RobotGrrl/EJA_v2/base_stage/base_stage.png

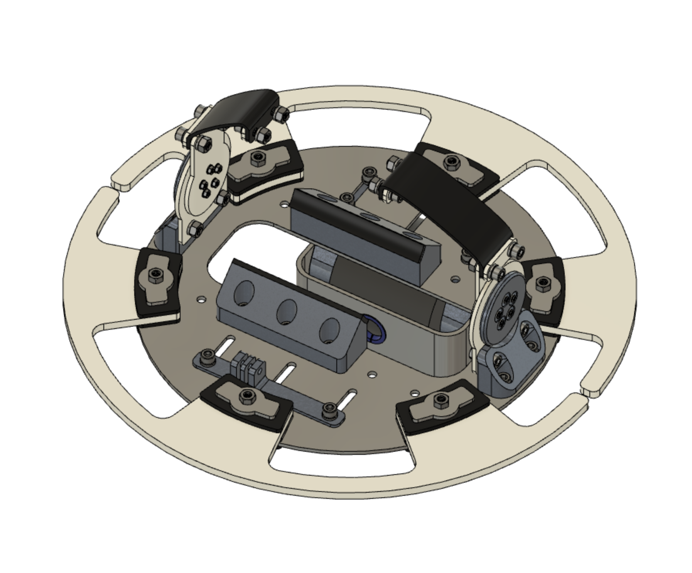
base_stage/base_stage.png
