RobotGrrl/EJA_v2/deck_stage/deck_stage.png

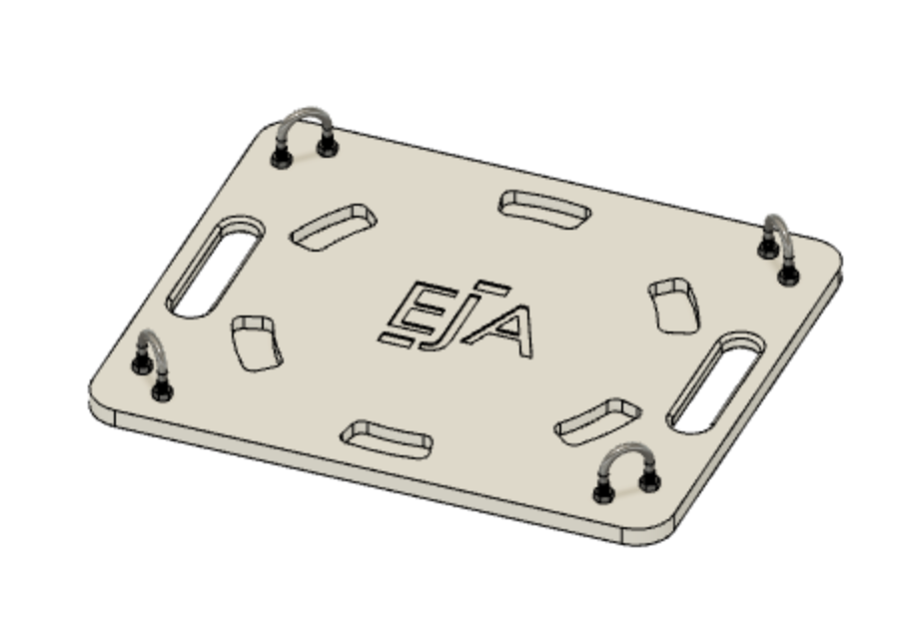
deck_stage/deck_stage.png
