RobotGrrl/EJA_v2/internal_buoy/O-ring 1:8 Internal - Milled Screenshot.png

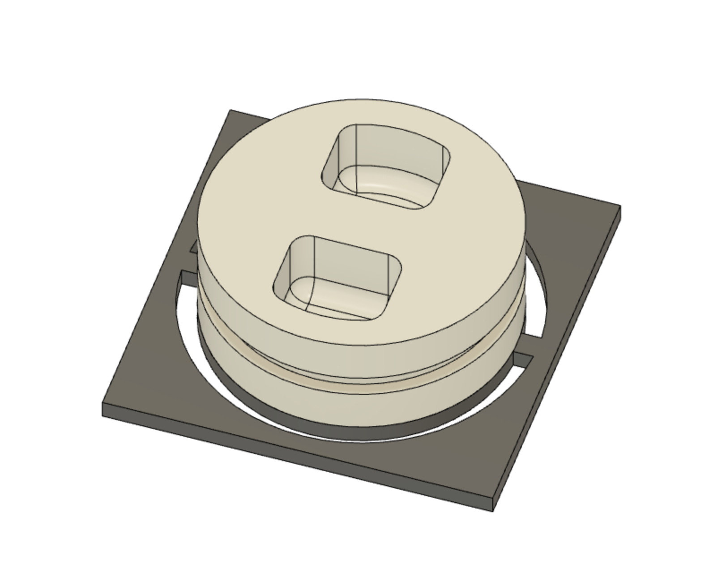
internal_buoy/O-ring 1:8 Internal - Milled Screenshot.png
