RobotGrrl/EJA_v2/lower_stage/lower_stage.png

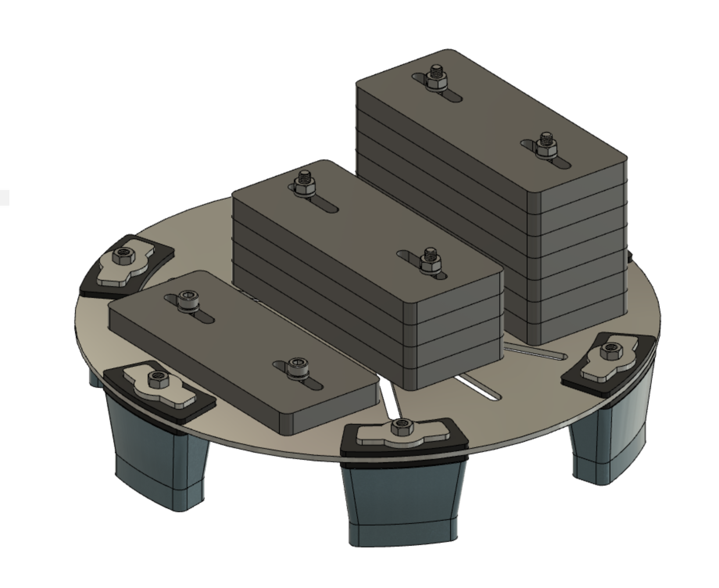
lower_stage/lower_stage.png
