RobotGrrl/EJA_v2/sim/sim.png

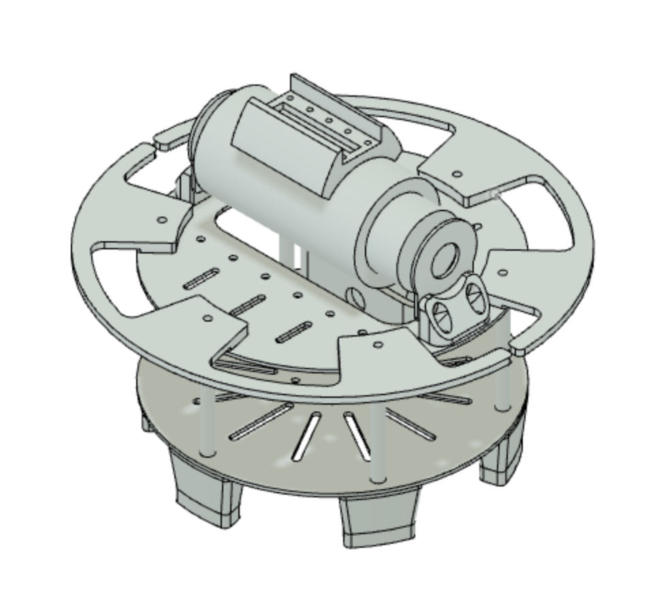
sim/sim.png
