RobotGrrl/EJA_v2/EJA v2 BOM [FINAL] - OTHER BOM.pdf

Item | Qty | Price | Cost
Paracord $14.80 (https://www.amazon.ca/WEREWOLVES-650lb-Paracord-Parachute-Cord/dp/B0922HQ9KZ?s=sports) | 1 | 14.8 | 14.8
Bungee cord $10.99 (https://www.amazon.ca/Paracord-Planet-Elastic-Crafting-Stretch/dp/B06X3RJ4P2) | 1 | 10.99 | 10.99
Carabiners 2x | 2 | 3 | 6
Nalgene 1L wide-mouth | 1 | 12 | 12

Magnets
Dimensions: 3/4" x 1/4" x 1/4" thick | 10 | 1.67 | 16.70 | https://www.kjmagnetics.com/proddetail.asp?prod=BC44 wiper
Dimensions: 3/16" dia. x 1/4" thick | 20 | 0.47 | 9.40 | https://www.kjmagnetics.com/proddetail.asp?prod=D34-N52 servo module (default A)
TOTAL | 69.89

Scratchpad of magnets tested

description | price | num buoys | qty | cost | link | note
Dimensions: 1/4" dia. x 1/4" thick | 0.72 | 1 | 25 | 18.00 https://www.kjmagnetics.com/proddetail.asp?prod=D44-N52 wiper
Dimensions: 1/2" x 1/4" x 1/4" thick | 1.17 | 1 | 15 | 17.55 https://www.kjmagnetics.com/proddetail.asp?prod=B844 wiper
Dimensions: 3/4" x 1/4" x 1/4" thick | 1.67 | 1 | 10 | 16.70 https://www.kjmagnetics.com/proddetail.asp?prod=BC44 wiper
Dimensions: 3/16" dia. x 1/4" thick | 0.47 | 4 | 20 | 9.40 https://www.kjmagnetics.com/proddetail.asp?prod=D34-N52 servo module (default A)
Dimensions: 3/16" dia. x 1/8" thick | 0.29 | 4 | 20 | 5.80 https://www.kjmagnetics.com/proddetail.asp?prod=D32-N52 servo module (B)
total | 67.45
