RobotGrrl/EJA_v2/EJA v2 BOM [FINAL].xlsx

Sheet: COMPLETE FASTENER BOM
 | EJA v2 Bill of Materials Please read through and observe the notes. There might be some differences in the pricing! Last updated: Nov. 4, 2021
 | Useful Links: hackaday.io project page Design Github repository Electronics Github repository
Component | Location | Qty | Part Number | Part Qty | Pack Cost | Pack Qty | TOTAL Cost | Notes | Pack / Qty Needed | # of Packs Needed for 4 Complete Assemblies | Pack / Qty Needed | TOTAL Cost
M6 Hex nut | Lower stage | 24
M6 Hex nut | Base stage | 8
M6 Hex nut | External buoy | 2
TOTAL M6 Hex nut |  | 34 | 90591A151 (https://www.mcmaster.com/90591A151) | 1 | 2.99 | 100 | 2.99 |  | 2.941176471 | 2 | 5.882352941 | 5.98
M6 Washer | Base stage | 20
M6 Washer | Lower stage | 16
M6 Washer | External buoy | 4
TOTAL M6 Washer |  | 40 | 98688A116 (https://www.mcmaster.com/98688A116) | 2 | 4.29 | 100 | 8.58 | It seemed like we needed more than 100, go with 200 | 2.5 | 2 | 5 | 8.58
M6 x 16 mm | Base stage | 20 | 90128A263 (https://www.mcmaster.com/90128A263) | 1 | 10.36 | 100 | 10.36 |  | 5 | 1 | 5 | 10.36
M6 x 20 mm | Base stage | 8 | 90128A264 (https://www.mcmaster.com/90128A264) | 1 | 11.97 | 100 | 11.97 |  | 12.5 | 1 | 12.5 | 11.97
M6 x 25 mm | Lower stage | 2 | 90128A265 (https://www.mcmaster.com/90128A265) | 1 | 13.22 | 100 | 13.22 |  | 50 | 1 | 50 | 13.22
M6 x 35 mm | External buoy | 2 | 90128A267 (https://www.mcmaster.com/90128A267) | 1 | 8.59 | 50 | 8.59 |  | 25 | 1 | 25 | 8.59
M6 x 40 mm | Lower stage | 2
M6 x 50 mm | Lower stage | 2
M6 x 60 mm | Lower stage | 2 | 90128A271 (https://www.mcmaster.com/90128A271/) | 1 | 6.43 | 25 | 6.43
M6 Wing Nut | Lower stage | 8 | 94300A330 (https://www.mcmaster.com/94300A330) | 1 | 6.09 | 25 | 6.09 |  | 3.125 | 2 | 6.25 | 12.18
M3 Washers | Base stage | 20
M3 Washers | External wiper | 10
M3 Washer | Internal buoy | 46
TOTAL M3 Washers |  | 76 | 93475A210 (https://www.mcmaster.com/93475A210) | 2 | 1.62 | 100 | 3.24 | It seemed like we needed more than 100, go with 200 | 1.315789474 | 4 | 5.263157895 | 6.48
M3 Hex Nut | Base stage | 10
M3 Hex Nut | Internal buoy | 20
TOTAL M3 Hex nut |  | 30 | 90591A250 (https://www.mcmaster.com/90591A250) | 1 | 2.67 | 100 | 2.67 |  | 3.333333333 | 2 | 6.666666667 | 5.34
M3 Heatset | External wiper | 10
M3 Heatset | Internal buoy | 8
TOTAL M3 Heatset |  | 18 | 94180A331 (https://www.mcmaster.com/94180A331) | 1 | 14.71 | 100 | 14.71 |  | 5.555555556 | 1 | 5.555555556 | 14.71
M3 x 8 mm Thin | Internal buoy | 4 | 90666A104 (https://www.mcmaster.com/90666A104) | 1 | 8.4 | 100 | 8.4 |  | 25 | 1 | 25 | 8.4
M3 x 8 mm | Internal buoy | 22 | 91290A113 (https://www.mcmaster.com/91290A113) | 0 | 8.12 | 100 | 0 |  | 4.545454545 | 1 | 4.545454545 | 8.12
M3 x 8 mm | Internal buoy | 22 | 95263A122 (https://www.mcmaster.com/95263A122/) | 1 | 8.12 | 100 | 8.12
M3 x 10 mm | Internal buoy | 4 | 95263A134 (https://www.mcmaster.com/95263A134) | 1 | 8.14 | 50 | 8.14 |  | 12.5 | 1 | 12.5 | 8.14
M3 x 14 mm | Base stage | 10 | 91502A106 (https://www.mcmaster.com/91502A106) | 1 | 11.95 | 100 | 11.95 |  | 10 | 1 | 10 | 11.95
M3 x 16 mm | External wiper | 10 | 91290A120 (https://www.mcmaster.com/91290A120) | 1 | 10.11 | 100 | 10.11 |  | 10 | 1 | 10 | 10.11
M3 Hex Nut Thin | Internal buoy | 4 | 90695A033 (https://www.mcmaster.com/90695A033) | 1 | 4.03 | 100 | 4.03 |  | 25 | 1 | 25 | 4.03
M3 Nylon Washer | Internal buoy | 12 | 95610A130 (https://www.mcmaster.com/95610A130) | 1 | 3.81 | 100 | 3.81 | These 4 and the next 4 had supplychain issues - so it's a mixture of both | 8.333333333 | 1 | 8.333333333 | 3.81
M3 Nylon Hex Nut | Internal buoy | 4 | 93800A116 (https://www.mcmaster.com/mv1630010695/itmLookup/itmLookup.aspx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) | 0 | 14.64 | 100 | 0 | These 4 and the next 4 had supplychain issues - so it's a mixture of both | 25 | 1 | 25 | 14.64
M3 x 10 mm Nylon | Internal buoy | 2 | 92492A718 (https://www.mcmaster.com/92492A718-94879A120/) | 0 | 10.04 | 100 | 0 | These 4 and the next 4 had supplychain issues - so it's a mixture of both | 50 | 1 | 50 | 10.04
M3 x 16 mm Nylon | Internal buoy | 2 | 94879A126 (https://www.mcmaster.com/mv1630010695/itmLookup/itmLookup.aspx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) | 0 | 10.2 | 100 | 0 | These 4 and the next 4 had supplychain issues - so it's a mixture of both | 50 | 1 | 50 | 10.2
4-40 Nylon Washer | Internal buoy | 12 | 90295A345 (https://www.mcmaster.com/90295A345-90295A045/) | 0 | 3.81 | 100 | 0 | These 4 and the next 4 had supplychain issues - so it's a mixture of both | 8.333333333 | 1 | 8.333333333 | 3.81
4-40 Nylon Hex Nut | Internal buoy | 4 | 94812A200 (https://www.mcmaster.com/94812A200-94812A112/) | 1 | 14.64 | 100 | 14.64 | These 4 and the next 4 had supplychain issues - so it's a mixture of both | 25 | 1 | 25 | 14.64
4-40 x 7/16" (10 mm) Nylon | Internal buoy | 2 | 95868A259 (https://www.mcmaster.com/95868A259-95868A109/) | 1 | 10.04 | 100 | 10.04 | These 4 and the next 4 had supplychain issues - so it's a mixture of both | 50 | 1 | 50 | 10.04
4-40 x 11/16" (16 mm) Nylon | Internal buoy | 2 | 95868A270 (https://www.mcmaster.com/95868A270-95868A120/) | 1 | 10.2 | 100 | 10.2 | These 4 and the next 4 had supplychain issues - so it's a mixture of both | 50 | 1 | 50 | 10.2
M2 Heatset | Internal buoy | 8 | 94180A312 (https://www.mcmaster.com/94180A312) | 1 | 15.04 | 100 | 15.04 |  | 12.5 | 1 | 12.5 | 15.04
M2 Washer | Internal buoy | 8 | 93475A195 (https://www.mcmaster.com/93475A195) | 1 | 1.36 | 100 | 1.36 |  | 12.5 | 1 | 12.5 | 1.36
M2 x 6 mm | Internal buoy | 4 | 91292A831 (https://www.mcmaster.com/91292A831) | 1 | 6 | 100 | 6 |  | 25 | 1 | 25 | 6
M2 x 10 mm | Internal buoy | 4 | 90128A181 (https://www.mcmaster.com/90128A181) | 1 | 12.88 | 100 | 12.88 |  | 25 | 1 | 25 | 12.88
M6 x 80 mm Threaded rod | Lower stage (Ballast) | 2
M6 x 115 mm Threaded rod | Lower stage (Ballast) | 2
M6 x 160 mm Threaded Rod | Base stage (Spool) | 1
M6 x 170 mm Threaded Rod | Assembly | 6
M6 Threaded Rods |  | 9 | 98863A542 (https://www.mcmaster.com/98863A542) | 1 | 3.31 | 1 | 3.31 |  | 0.1111111111 | 36 | 4 | 119.16
1/4" dia x 1/4" len Magnet | External wiper | 5 | 5862K116 (https://www.mcmaster.com/5862K116) | 0 | 0.97 | 0 | 0 | Magnets purchased from K&J magnetics | 0 | 25 | 0 | 24.25
1/4" dia x 1/4" len Magnet | Internal buoy | 7 | 5862K116 (https://www.mcmaster.com/5862K116) | 0 | 0.97 | 0 | 0 | Magnets purchased from K&J magnetics | 0 | 35 | 0 | 33.95
3/16" dia x 1/4" len Magnet | Internal buoy | 4 | 5862K115 (https://www.mcmaster.com/5862K115) | 0 | 0.88 | 1 | 0 | Magnets purchased from K&J magnetics | 0.25 | 16 | 4 | 14.08
O-ring | Internal buoy | 1 | 9452K62 (https://www.mcmaster.com/9452K62) | 1 | 15.07 | 100 | 15.07 |  | 100 | 1 | 100 | 15.07
Foam | External buoy and Base stage | 0.25 | 7503N61 (https://www.mcmaster.com/7503N61) | 1 | 14.87 | 1 | 14.87 |  | 4 | 1 | 4 | 14.87
U-Bolt | Deck stage | 4 | 3043T614 (https://www.mcmaster.com/3043T614) | 1 | 3.74 | 5 | 3.74 |  | 1.25 | 4 | 5 | 14.96
1/4"-20 Hex Nut | Deck stage | 16 | 95462A029 (https://www.mcmaster.com/95462A029) | 1 | 5.56 | 100 | 5.56 |  | 6.25 | 1 | 6.25 | 5.56
 |  |  |  |  | FASTENERS TOTAL |  | 256.12 |  |  |  | GRAND TOTAL | 502.72
 |  |  |  |  | OTHER TOTAL |  | 69.89
 |  |  |  |  | GRAND TOTAL |  | 326.01

Sheet: OTHER BOM
Item | Qty | Price | Cost
Paracord $14.80 (https://www.amazon.ca/WEREWOLVES-650lb-Paracord-Parachute-Cord/dp/B0922HQ9KZ?s=sports) | 1 | 14.8 | 14.8
Bungee cord $10.99 (https://www.amazon.ca/Paracord-Planet-Elastic-Crafting-Stretch/dp/B06X3RJ4P2) | 1 | 10.99 | 10.99
Carabiners 2x | 2 | 3 | 6
Nalgene 1L wide-mouth | 1 | 12 | 12
Magnets
Dimensions: 3/4" x 1/4" x 1/4" thick | 10 | 1.67 | 16.70 |  | https://www.kjmagnetics.com/proddetail.asp?prod=BC44 | wiper
Dimensions: 3/16" dia. x 1/4" thick | 20 | 0.47 | 9.40 |  | https://www.kjmagnetics.com/proddetail.asp?prod=D34-N52 | servo module (default A)
 |  | TOTAL | 69.89
Scratchpad of magnets tested
description | price | num buoys | qty | cost | link | note
Dimensions: 1/4" dia. x 1/4" thick | 0.72 | 1 | 25 | 18.00 | https://www.kjmagnetics.com/proddetail.asp?prod=D44-N52 | wiper
Dimensions: 1/2" x 1/4" x 1/4" thick | 1.17 | 1 | 15 | 17.55 | https://www.kjmagnetics.com/proddetail.asp?prod=B844 | wiper
Dimensions: 3/4" x 1/4" x 1/4" thick | 1.67 | 1 | 10 | 16.70 | https://www.kjmagnetics.com/proddetail.asp?prod=BC44 | wiper
Dimensions: 3/16" dia. x 1/4" thick | 0.47 | 4 | 20 | 9.40 | https://www.kjmagnetics.com/proddetail.asp?prod=D34-N52 | servo module (default A)
Dimensions: 3/16" dia. x 1/8" thick | 0.29 | 4 | 20 | 5.80 | https://www.kjmagnetics.com/proddetail.asp?prod=D32-N52 | servo module (B)
 |  |  | total | 67.45

Sheet: Threaded Rod Calculator
M6 x 80 mm Threaded rod | Lower stage (Ballast) | 2 | 200 mm
M6 x 115 mm Threaded rod | Lower stage (Ballast) | 2 | Len 1 | Len 2 | Remainder
M6 x 160 mm Threaded Rod | Base stage (Spool) | 1 | 80 | 115 | 5
M6 x 170 mm Threaded Rod | Assembly | 6 | 80 | 115 | 5
 |  |  | 170 |  | 30
 |  |  | 170 |  | 30
 |  |  | 170 |  | 30
 |  |  | 170 |  | 30
 |  |  | 170 |  | 30
 |  |  | 170 |  | 30
 |  |  | 160 |  | 40
 |  |  | 200 mm x 9 | 29.79 | WINNER

Sheet: Lower Stage
Component | Location | Quantity | Part Number (Benchtop) | Part Cost (Benchtop) | Part Number (Deployed) | Part Cost (Deployed) | Notes | M6 Hex Nut | M6 Washer | M6 Hex Nut | M6 Washer
M6 Hex nut | Bumper-washer top | 6 | 90591A151 |  |  |  |  | 1 |  | 6 | 0
M6 Hex nut | Stands | 6 | 90591A151 |  |  |  |  | 1 |  | 6 | 0
M6 Hex nut | Ballast bay 3 | 2 | 90591A151 |  |  |  |  | 1 |  | 2 | 0
M6 Washer | Ballast bay 3 | 4 | 98688A116 |  |  |  |  |  | 1 | 0 | 4
M6 x 25 mm | Ballast bay 3 | 2 | 90128A265 |  |  |  |  |  |  | 0 | 0
M6 Hex nut | Ballast bay 2 | 4 | 90591A151 |  |  |  |  | 1 |  | 4 | 0
M6 Washer | Ballast bay 2 | 4 | 98688A116 |  |  |  |  |  | 1 | 0 | 4
M6 x 80 mm Threaded rod | Ballast bay 2 | 2 | TODO |  | 98863A542 |  | Cut to 80 mm Stack of 4 x 1/2" ballasts |  |  | 0 | 0
M6 Hex nut | Ballast bay 1 | 4 | 90591A151 |  |  |  |  | 1 |  | 4 | 0
M6 Washer | Ballast bay 1 | 4 | 98688A116 |  |  |  |  |  | 1 | 0 | 4
M6 x 115 mm Threaded rod | Ballast bay 1 | 2 | TODO |  | 98863A542 |  | Cut to 115 mm Stack of 7 x 1/2" ballasts |  |  | 0 | 0
M6 Hex nut | Ballast bay (optional) | 2 | 90591A151 |  |  |  |  | 1 |  | 2 | 0
M6 Washer | Ballast bay (optional) | 4 | 98688A116 |  |  |  |  |  | 1 | 0 | 4
M6 x 40 mm | Ballast bay (optional) | 2 | TODO |  |  |  | Stack of 2 x 1/2" ballasts |  |  | 0 | 0
M6 x 50 mm | Ballast bay (optional) | 2 | TODO |  |  |  | Stack of 3 x 1/2" ballasts |  |  | 0 | 0
M6 x 70 mm | Ballast bay (optional) | 2 | TODO |  |  |  | Stack of 4 x 1/2" ballasts |  |  | 0 | 0
 |  |  |  |  |  |  |  |  |  | 24 | 16
TOTAL BOM
M6 Hex nut | 24
M6 Washer | 16
M6 x 25 mm | 2
M6 x 80 mm Threaded rod | 2
M6 x 115 mm Threaded rod | 2
M6 x 40 mm | 2
M6 x 50 mm | 2
M6 x 70 mm | 2

Sheet: Base Stage
Component | Location | Quantity | Part Number (Benchtop) | Part Cost (Benchtop) | Part Number (Deployed) | Part Cost (Deployed) | Notes | M6 Washer | M6 Hex Nut | M6 x 16 mm | M6 x 20 mm | M3 Washers | M3 Hex Nut | M3 x 14 mm | M6 Washer | M6 Hex Nut | M6 x 16 mm | M6 x 20 mm | M3 Washers | M3 Hex Nut | M3 x 14 mm
M6 Hex nut | Fasteners - Rod (mirror) lower surface | 6 |  |  |  |  |  |  | 1 |  |  |  |  |  | 0 | 6 | 0 | 0 | 0 | 0 | 0
M6 Hex nut | Fasteners - Rod top surface | 6 |  |  |  |  |  |  | 1 |  |  |  |  |  | 0 | 6 | 0 | 0 | 0 | 0 | 0
Nylon grommet | Spool | 1 |  |  |  |  |  |  |  |  |  |  |  |  | 0 | 0 | 0 | 0 | 0 | 0 | 0
M6 Washers | Spool | 8 |  |  |  |  |  | 1 |  |  |  |  |  |  | 8 | 0 | 0 | 0 | 0 | 0 | 0
M6 Hex nut | Spool | 4 |  |  |  |  |  |  | 1 |  |  |  |  |  | 0 | 4 | 0 | 0 | 0 | 0 | 0
M6 x 16 mm | Spool | 4 |  |  |  |  |  |  |  | 1 |  |  |  |  | 0 | 0 | 4 | 0 | 0 | 0 | 0
M6 Washers | Spool | 2 |  |  |  |  |  | 1 |  |  |  |  |  |  | 2 | 0 | 0 | 0 | 0 | 0 | 0
M6 Hex nut | Spool | 2 |  |  |  |  |  |  | 1 |  |  |  |  |  | 0 | 2 | 0 | 0 | 0 | 0 | 0
M6 x 160 mm Threaded Rod | Spool | 1 |  |  |  |  |  |  |  |  |  |  |  |  | 0 | 0 | 0 | 0 | 0 | 0 | 0
M6 Washers | Sleeve-Base | 4 |  |  |  |  |  | 1 |  |  |  |  |  |  | 4 | 0 | 0 | 0 | 0 | 0 | 0
M6 Hex nut | Sleeve-Base | 2 |  |  |  |  |  |  | 1 |  |  |  |  |  | 0 | 2 | 0 | 0 | 0 | 0 | 0
M6 x 16 mm | Sleeve-Base | 2 |  |  |  |  |  |  |  | 1 |  |  |  |  | 0 | 0 | 2 | 0 | 0 | 0 | 0
M6 Washers | Sleeve-Base | 4 |  |  |  |  |  | 1 |  |  |  |  |  |  | 4 | 0 | 0 | 0 | 0 | 0 | 0
M6 Hex nut | Sleeve-Base | 2 |  |  |  |  |  |  | 1 |  |  |  |  |  | 0 | 2 | 0 | 0 | 0 | 0 | 0
M6 x 16 mm | Sleeve-Base | 2 |  |  |  |  |  |  |  | 1 |  |  |  |  | 0 | 0 | 2 | 0 | 0 | 0 | 0
M6 Washers | Sleeve-Base | 4 |  |  |  |  |  | 1 |  |  |  |  |  |  | 4 | 0 | 0 | 0 | 0 | 0 | 0
M6 Hex nut | Sleeve-Base | 2 |  |  |  |  |  |  | 1 |  |  |  |  |  | 0 | 2 | 0 | 0 | 0 | 0 | 0
M6 x 20 mm | Sleeve-Base | 2 |  |  |  |  |  |  |  |  | 1 |  |  |  | 0 | 0 | 0 | 2 | 0 | 0 | 0
M6 Washers | Sleeve-Base | 4 |  |  |  |  |  | 1 |  |  |  |  |  |  | 4 | 0 | 0 | 0 | 0 | 0 | 0
M6 Hex nut | Sleeve-Base | 2 |  |  |  |  |  |  | 1 |  |  |  |  |  | 0 | 2 | 0 | 0 | 0 | 0 | 0
M6 x 20 mm | Sleeve-Base | 2 |  |  |  |  |  |  |  |  | 1 |  |  |  | 0 | 0 | 0 | 2 | 0 | 0 | 0
M3 Washers | Sleeve-Base | 10 |  |  |  |  |  |  |  |  |  | 1 |  |  | 0 | 0 | 0 | 0 | 10 | 0 | 0
M3 Hex nut | Sleeve-Base | 5 |  |  |  |  |  |  |  |  |  |  | 1 |  | 0 | 0 | 0 | 0 | 0 | 5 | 0
M3 x 14 mm | Sleeve-Base | 5 |  |  |  |  |  |  |  |  |  |  |  | 1 | 0 | 0 | 0 | 0 | 0 | 0 | 5
M6 Washers | Sleeve-Base Mirror | 4 |  |  |  |  |  | 1 |  |  |  |  |  |  | 4 | 0 | 0 | 0 | 0 | 0 | 0
M6 Hex nut | Sleeve-Base Mirror | 2 |  |  |  |  |  |  | 1 |  |  |  |  |  | 0 | 2 | 0 | 0 | 0 | 0 | 0
M6 x 16 mm | Sleeve-Base Mirror | 2 |  |  |  |  |  |  |  | 1 |  |  |  |  | 0 | 0 | 2 | 0 | 0 | 0 | 0
M6 Washers | Sleeve-Base Mirror | 4 |  |  |  |  |  | 1 |  |  |  |  |  |  | 4 | 0 | 0 | 0 | 0 | 0 | 0
M6 Hex nut | Sleeve-Base Mirror | 2 |  |  |  |  |  |  | 1 |  |  |  |  |  | 0 | 2 | 0 | 0 | 0 | 0 | 0
M6 x 16 mm | Sleeve-Base Mirror | 2 |  |  |  |  |  |  |  | 1 |  |  |  |  | 0 | 0 | 2 | 0 | 0 | 0 | 0
M6 Washers | Sleeve-Base Mirror | 4 |  |  |  |  |  | 1 |  |  |  |  |  |  | 4 | 0 | 0 | 0 | 0 | 0 | 0
M6 Hex nut | Sleeve-Base Mirror | 2 |  |  |  |  |  |  | 1 |  |  |  |  |  | 0 | 2 | 0 | 0 | 0 | 0 | 0
M6 x 20 mm | Sleeve-Base Mirror | 2 |  |  |  |  |  |  |  |  | 1 |  |  |  | 0 | 0 | 0 | 2 | 0 | 0 | 0
M6 Washers | Sleeve-Base Mirror | 4 |  |  |  |  |  | 1 |  |  |  |  |  |  | 4 | 0 | 0 | 0 | 0 | 0 | 0
M6 Hex nut | Sleeve-Base Mirror | 2 |  |  |  |  |  |  | 1 |  |  |  |  |  | 0 | 2 | 0 | 0 | 0 | 0 | 0
M6 x 20 mm | Sleeve-Base Mirror | 2 |  |  |  |  |  |  |  |  | 1 |  |  |  | 0 | 0 | 0 | 2 | 0 | 0 | 0
M3 Washers | Sleeve-Base Mirror | 10 |  |  |  |  |  |  |  |  |  | 1 |  |  | 0 | 0 | 0 | 0 | 10 | 0 | 0
M3 Hex nut | Sleeve-Base Mirror | 5 |  |  |  |  |  |  |  |  |  |  | 1 |  | 0 | 0 | 0 | 0 | 0 | 5 | 0
M3 x 14 mm | Sleeve-Base Mirror | 5 |  |  |  |  |  |  |  |  |  |  |  | 1 | 0 | 0 | 0 | 0 | 0 | 0 | 5
M6 Washers | Holder | 6 |  |  |  |  |  | 1 |  |  |  |  |  |  | 6 | 0 | 0 | 0 | 0 | 0 | 0
M6 Hex nut | Holder | 3 |  |  |  |  |  |  | 1 |  |  |  |  |  | 0 | 3 | 0 | 0 | 0 | 0 | 0
M6 x 16 mm | Holder | 3 |  |  |  |  |  |  |  | 1 |  |  |  |  | 0 | 0 | 3 | 0 | 0 | 0 | 0
M6 Washers | Holder Mirror | 6 |  |  |  |  |  | 1 |  |  |  |  |  |  | 6 | 0 | 0 | 0 | 0 | 0 | 0
M6 Hex nut | Holder Mirror | 3 |  |  |  |  |  |  | 1 |  |  |  |  |  | 0 | 3 | 0 | 0 | 0 | 0 | 0
M6 x 16 mm | Holder Mirror | 3 |  |  |  |  |  |  |  | 1 |  |  |  |  | 0 | 0 | 3 | 0 | 0 | 0 | 0
M6 Washers | GoPro | 4 |  |  |  |  |  | 1 |  |  |  |  |  |  | 4 | 0 | 0 | 0 | 0 | 0 | 0
M6 Hex nut | GoPro | 2 |  |  |  |  |  |  | 1 |  |  |  |  |  | 0 | 2 | 0 | 0 | 0 | 0 | 0
M6 x 16 mm | GoPro | 2 |  |  |  |  |  |  |  | 1 |  |  |  |  | 0 | 0 | 2 | 0 | 0 | 0 | 0
 |  |  |  |  |  |  |  |  |  |  |  |  |  |  | 58 | 42 | 20 | 8 | 20 | 10 | 10
TOTAL BOM
M6 Washer | 58
M6 Hex Nut | 42
M6 x 16 mm | 20
M6 x 20 mm | 8
M3 Washers | 20
M3 Hex Nut | 10
M3 x 14 mm | 10
Nylon grommet | 1
M6 x 160 mm Threaded Rod | 1

Sheet: External Wiper
Component | Location | Quantity | Part Number (Benchtop) | Part Cost (Benchtop) | Part Number (Deployed) | Part Cost (Deployed) | Notes | M6 Hex Nut | M6 Washer | M6 Hex Nut | M6 Washer
M3 x 16 mm | Cap | 10 | 91290A120 |  |  |  |  | 1 |  | 10 | 0
M3 Washer | Cap | 10 | 93475A210 |  |  |  |  | 1 |  | 10 | 0
M3 Heatset | Seatbelt | 10 | 94180A331 |  | 94180A331 |  |  | 1 |  | 10 | 0
Magnets | Holder | 5 |  |  |  |  |  |  |  | 30 | 0
TOTAL BOM
M3 x 16 mm | 10
M3 Washer | 10
M3 Heatset | 10

Sheet: Internal Buoy
Component | Location | Quantity | Part Number (Benchtop) | Part Cost (Benchtop) | Part Number (Deployed) | Part Cost (Deployed) | Notes | M3 Hex Nut | M3 Washer | M3 x 8 mm | M3 Hex Nut | M3 Washer | M3 x 8 mm
M3 x 8 mm | Internal Wiper - Holder | 16 | 91290A113 |  |  |  |  |  |  | 1 | 0 | 0 | 16
M3 Washer | Internal Wiper - Holder | 32 | 93475A210 |  |  |  |  |  | 1 |  | 0 | 32 | 0
M3 Hex Nut | Internal Wiper - Holder | 16 | 90591A250 |  |  |  |  | 1 |  |  | 16 | 0 | 0
M3 x 8 mm Thin | Internal Wiper - Servo Horn | 4 | 90666A104 |  |  |  |  |  |  |  | 0 | 0 | 0
M3 Hex Nut Thin | Internal Wiper - Servo Horn | 4 | 90695A033 |  |  |  |  |  |  |  | 0 | 0 | 0
Magnets | Internal Wiper - Holder | 7 |  |  |  |  |  |  |  |  | 0 | 0 | 0
 |  |  |  |  |  |  |  |  |  |  | 0 | 0 | 0
M3 Washer | Servo Module - Servo Bracket Front | 8 |  |  |  |  |  |  | 1 |  | 0 | 8 | 0
M3 Heatset | Servo Module - Servo Bracket Back | 4 |  |  |  |  |  |  |  |  | 0 | 0 | 0
M3 x 8 mm | Servo Module - Servo Bracket Front | 4 |  |  |  |  |  |  |  | 1 | 0 | 0 | 4
M3 Washer | Servo Module - Servo Bracket Front | 4 |  |  |  |  |  |  | 1 |  | 0 | 4 | 0
M3 Hex Nut | Servo Module - Servo Bracket Front | 4 |  |  |  |  |  | 1 |  |  | 4 | 0 | 0
M3 x 10 mm | Servo Module - Servo Bracket Front | 4 |  |  |  |  |  |  |  |  | 0 | 0 | 0
M2 Heatset | Servo Module - Servo Bracket Back | 4 |  |  |  |  |  |  |  |  | 0 | 0 | 0
M2 Washer | Servo Module - Servo Bracket Key | 4 |  |  |  |  |  |  |  |  | 0 | 0 | 0
M2 x 10 mm | Servo Module - Servo Bracket Key | 4 |  |  |  |  |  |  |  |  | 0 | 0 | 0
M2 Washer | Servo Module - Servo Bracket Mount | 4 |  |  |  |  |  |  |  |  | 0 | 0 | 0
M2 Heatset | Servo Module - Servo Bracket Mount | 4 |  |  |  |  |  |  |  |  | 0 | 0 | 0
M2 x 6 mm | Servo Module - Servo Bracket Mount | 4 |  |  |  |  |  |  |  |  | 0 | 0 | 0
3/16" dia x 1/4" len Magnet | Servo Module - Servo Bracket Back | 2 | 5862K115 |  |  |  |  |  |  |  | 0 | 0 | 0
3/16" dia x 1/4" len Magnet | Servo Module - Servo Bracket Mate | 2 | 5862K115 |  |  |  |  |  |  |  | 0 | 0 | 0
 |  |  |  |  |  |  |  |  |  |  | 0 | 0 | 0
M3 Nylon Washer | Bracket - Board | 12 | 95610A130 |  | 95610A130 |  |  |  |  |  | 0 | 0 | 0
M3 Nylon Hex Nut | Bracket - Board | 4 | 93800A116 |  | 93800A116 |  |  |  |  |  | 0 | 0 | 0
M3 x 16 mm Nylon | Bracket - Board | 2 | 94879A126 |  | 94879A126 |  |  |  |  |  | 0 | 0 | 0
M3 x 10 mm Nylon | Bracket - Board | 2 | 92492A718 |  | 92492A718 |  |  |  |  |  | 0 | 0 | 0
M3 x 8 mm | Bracket - Board - O-ring | 2 |  |  |  |  |  |  |  | 1 | 0 | 0 | 2
M3 Washer | Bracket - Board - O-ring | 2 |  |  |  |  |  |  | 1 |  | 0 | 2 | 0
 |  |  |  |  |  |  |  |  |  |  | 0 | 0 | 0
M3 Heatset | O-ring 1/8 Internal | 4 |  |  |  |  |  |  |  |  | 0 | 0 | 0
O-ring | O-ring 1/8 Internal | 1 |  |  |  |  |  |  |  |  | 0 | 0 | 0
 |  |  |  |  |  |  |  |  |  |  | 20 | 46 | 22
TOTAL BOM
M3 Hex Nut | 20
M3 Washer | 46
M3 x 8 mm | 22
M3 x 8 mm Thin | 4
M3 Hex Nut Thin | 4
Magnets | 7
M3 Heatset | 8
M3 x 10 mm | 4
M2 Heatset | 8
M2 Washer | 8
M2 x 10 mm | 4
M2 x 6 mm | 4
3/16" dia x 1/4" len Magnet | 4
M3 Nylon Washer | 12
M3 Nylon Hex Nut | 4
M3 x 16 mm Nylon | 2
M3 x 10 mm Nylon | 2
O-ring | 1

Sheet: External Buoy
Component | Location | Quantity | Part Number (Benchtop) | Part Cost (Benchtop) | Part Number (Deployed) | Part Cost (Deployed) | Notes | M6 Hex Nut | M6 Washer | M6 Hex Nut | M6 Washer
M6 Washer | Clamp | 4
M6 Hex Nut | Clamp | 2
M6 x 35 mm | Clamp | 2
Foam | Buoy | 0.25 | 7503N61 |  | 7503N61
TOTAL BOM
M6 Washer | 4
M6 Hex Nut | 2
M6 x 35 mm | 2
Foam | 0.25

Sheet: Deck Stage
Component | Location | Quantity | Part Number (Benchtop) | Part Cost (Benchtop) | Part Number (Deployed) | Part Cost (Deployed) | Notes | M6 Hex Nut | M6 Washer | M6 Hex Nut | M6 Washer
U-Bolt | Deck | 4 | 3043T614 | 3.74
1/4-20 Hex Nut | Deck | 16 | 95462A029 | 5.56
TOTAL BOM
