RobotGrrl/EJA_v2/sim/Eja Assembly CFD (v49) 4 v7.step

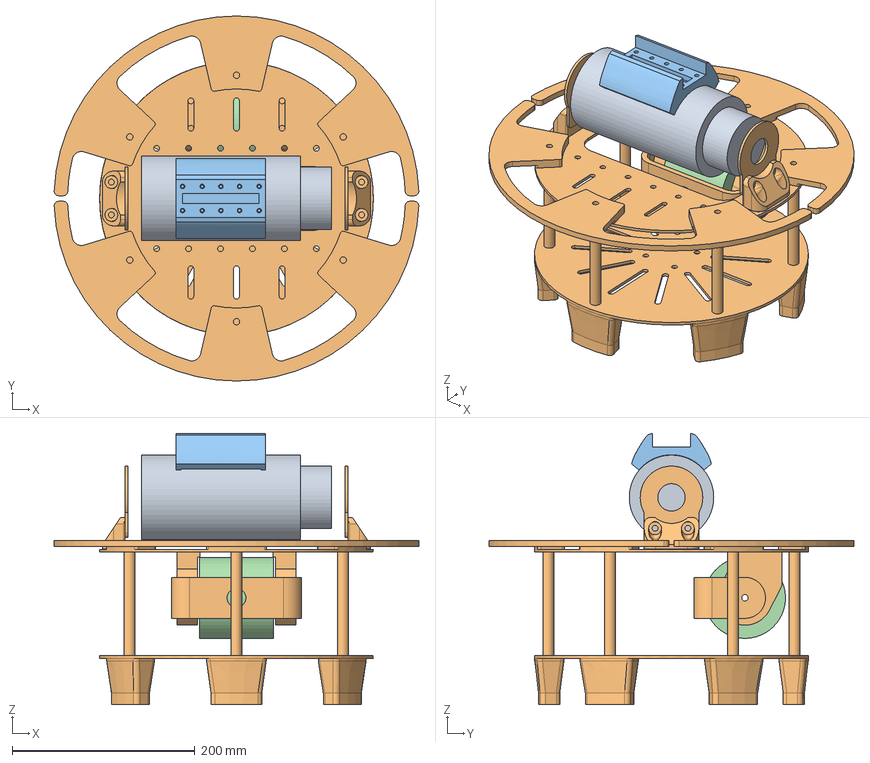
[picture p6: CAD file, 2021-11-04]
sim/Eja Assembly CFD (v49) 4 v7.step
399.7 x 400.0 x 297.5 mm
seatbelt (1)
sleeve (2)
sleeve(Mirror) (2)
sleeve-base bracket (2)
sleeve-base bracket(Mirror) (1)
