RobotGrrl/EJA_v2/assembly/rod_spacer_back.stl

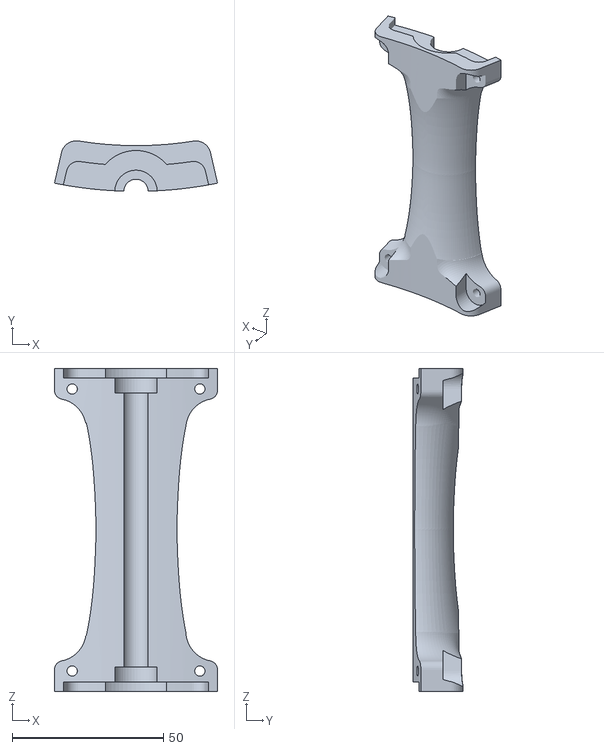
[picture p7: CAD file, 2021-11-04]
assembly/rod_spacer_back.stl
53.9 x 16.6 x 106.7
