RobotGrrl/EJA_v2/base_stage/clasp.dxf

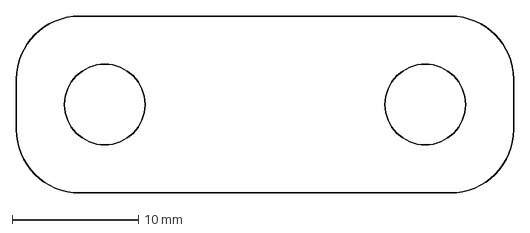
[picture p8: CAD file, 2021-11-04]
base_stage/clasp.dxf
39.4 x 14.0 mm
