RobotGrrl/EJA_v2/deck_stage/bungee_cord.stl

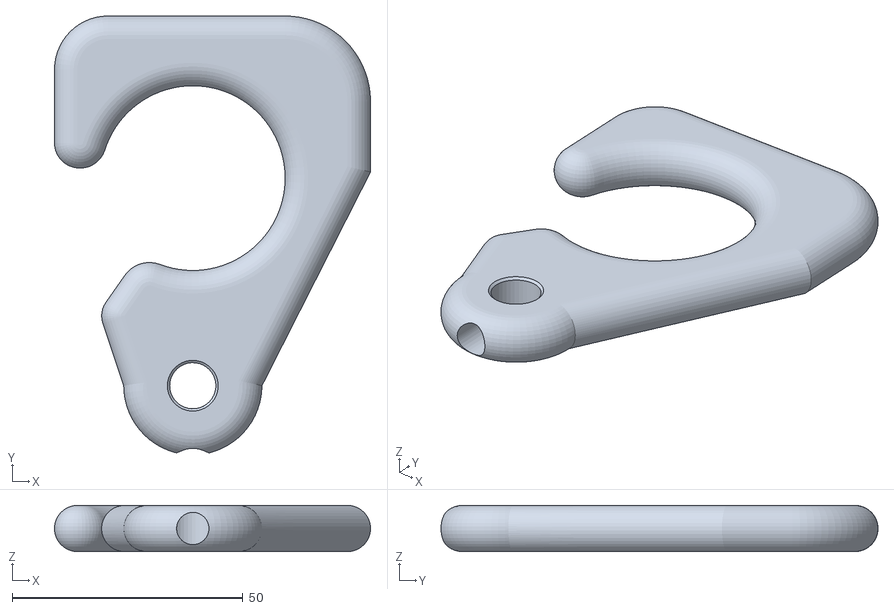
[picture p9: CAD file, 2021-11-04]
deck_stage/bungee_cord.stl
68.5 x 94.7 x 10.0
