RobotGrrl/EJA_v2/external_buoy/handle.dxf

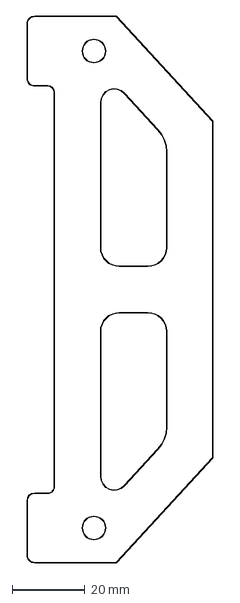
[picture p10: CAD file, 2021-11-04]
external_buoy/handle.dxf
51.0 x 150.0 mm
