RobotGrrl/EJA_v2/external_wiper/magnet_holder_blank.stl

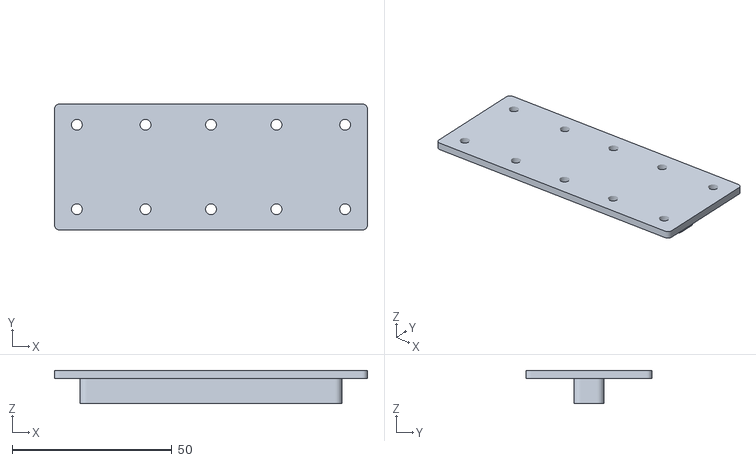
[picture p11: CAD file, 2021-11-04]
external_wiper/magnet_holder_blank.stl
97.9 x 39.4 x 10.4
