RobotGrrl/EJA_v2/internal_buoy/board.stl

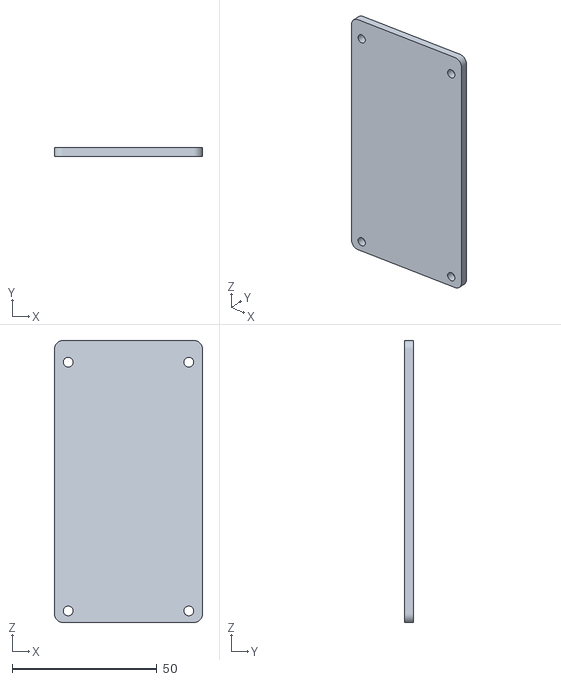
[picture p12: CAD file, 2021-11-04]
internal_buoy/board.stl
51.2 x 3.00 x 97.5
