RobotGrrl/EJA_v2/internal_wiper/metal_wiper_e.dxf

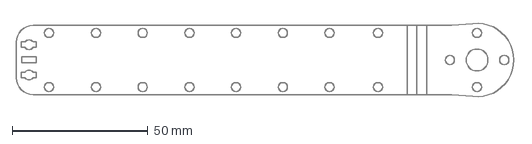
[picture p13: CAD file, 2021-11-04]
internal_wiper/metal_wiper_e.dxf
183.6 x 28.0 mm
