RobotGrrl/EJA_v2/lower_stage/Lower stage v71.step

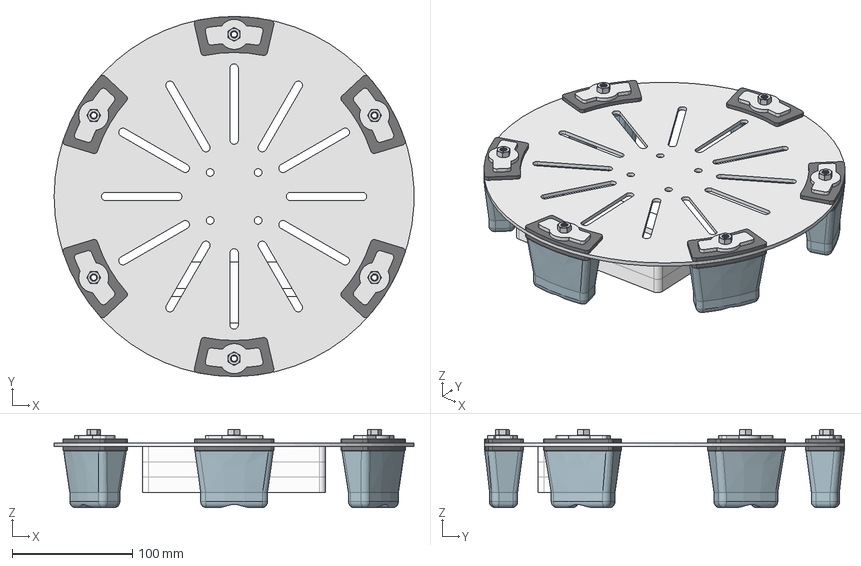
[picture p14: CAD file, 2021-11-04]
lower_stage/Lower stage v71.step
299.8 x 300.0 x 65.4 mm
base
bumper x 6
bumper(Mirror) x 6
washer x 6
M6 90591A151_ZINC-PLATED STEEL HEX NUT x 6
M6 98688A116_ METRIC GENERAL PURPOSE WASHERS x 6
M6 90591A151_ZINC-PLATED STEEL HEX NUT_1 x 6
leg (1) x 6
ballast lower bay 1
