RobotGrrl/EJA_v2/magnet_holders/internal_magnet_holder.stl

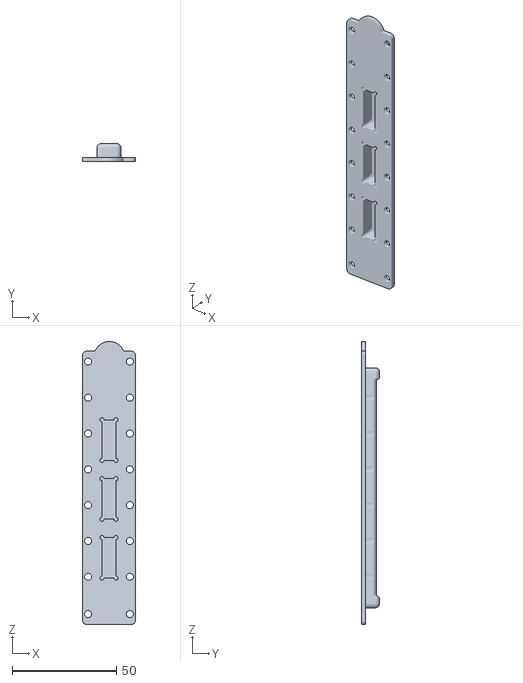
[picture p15: CAD file, 2021-11-04]
magnet_holders/internal_magnet_holder.stl
25.4 x 8.65 x 135.6
