RobotGrrl/EJA_v2/servo_module/bracket_front.stl

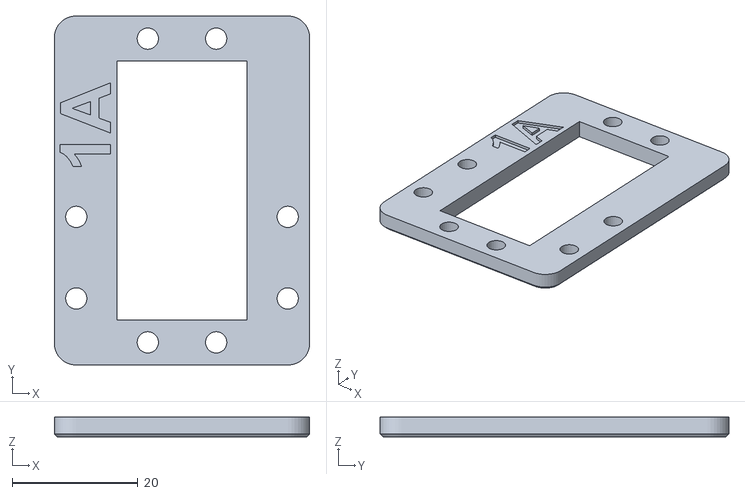
[picture p16: CAD file, 2021-11-04]
servo_module/bracket_front.stl
40.7 x 55.6 x 3.18
