RobotGrrl/EJA_v2/servo_module/v1/servo_bracket_back.stl

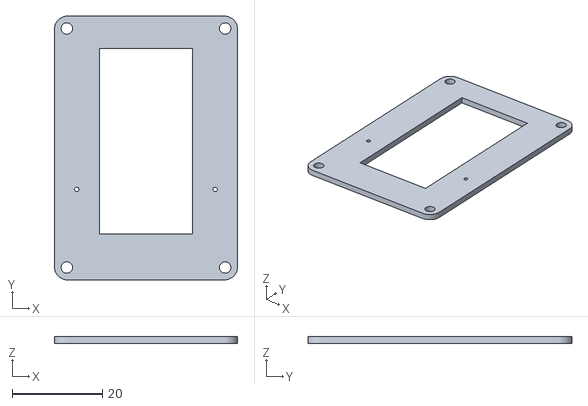
[picture p17: CAD file, 2021-11-04]
servo_module/v1/servo_bracket_back.stl
40.7 x 58.6 x 1.50
