RobotGrrl/EJA_v2/assembly/rod_spacer_front.stl

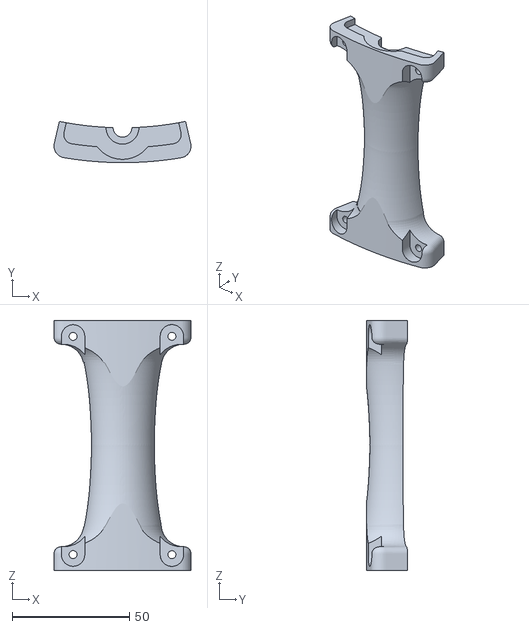
[picture p18: CAD file, 2021-11-04]
assembly/rod_spacer_front.stl
58.5 x 17.6 x 106.7
