RobotGrrl/EJA_v2/base_stage/holder_foam.dxf

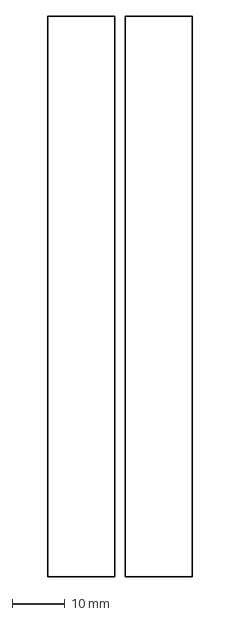
[picture p19: CAD file, 2021-11-04]
base_stage/holder_foam.dxf
27.4 x 105.9 mm
