RobotGrrl/EJA_v2/deck_stage/deck_stage_base.stl

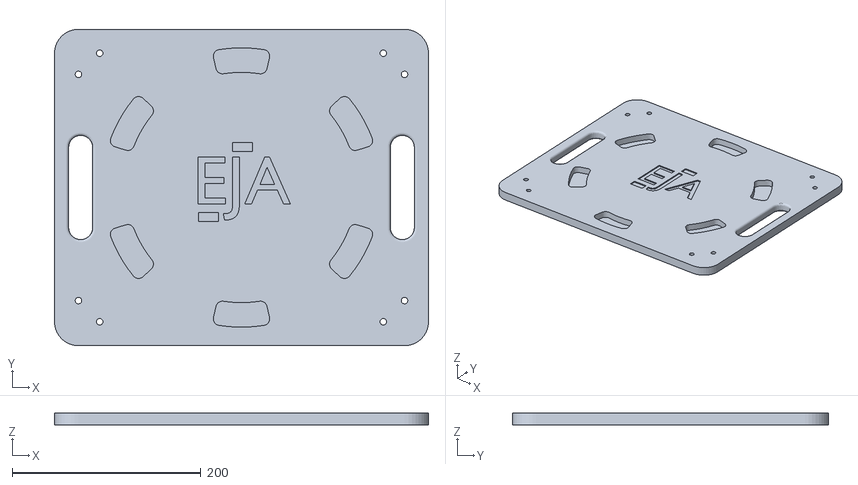
[picture p20: CAD file, 2021-11-04]
deck_stage/deck_stage_base.stl
396.2 x 335.3 x 12.7
