RobotGrrl/EJA_v2/external_buoy/do_not_use_clamp_A1.stl

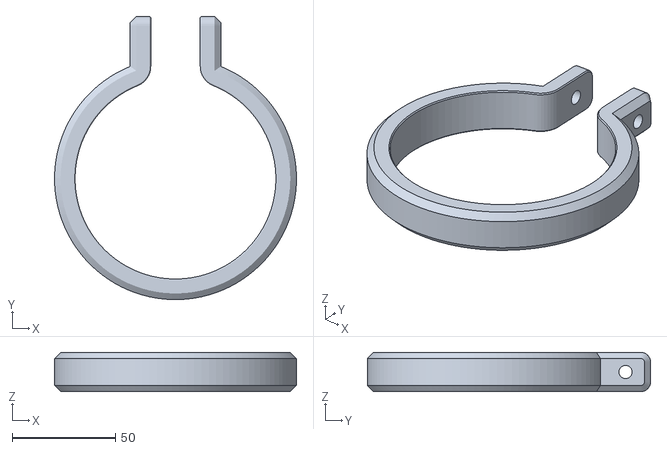
[picture p21: CAD file, 2021-11-04]
external_buoy/do_not_use_clamp_A1.stl
117.4 x 137.4 x 19.0
