RobotGrrl/EJA_v2/external_wiper/gasket.stl

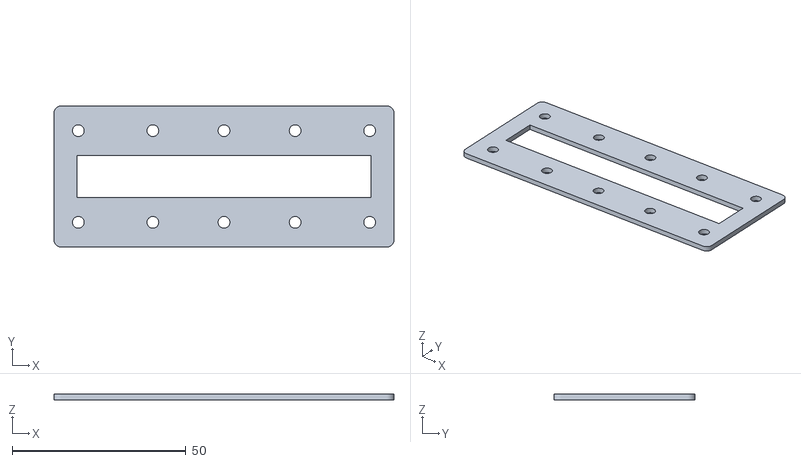
[picture p22: CAD file, 2021-11-04]
external_wiper/gasket.stl
97.9 x 40.6 x 1.59
