RobotGrrl/EJA_v2/internal_buoy/o-ring_A5.stl

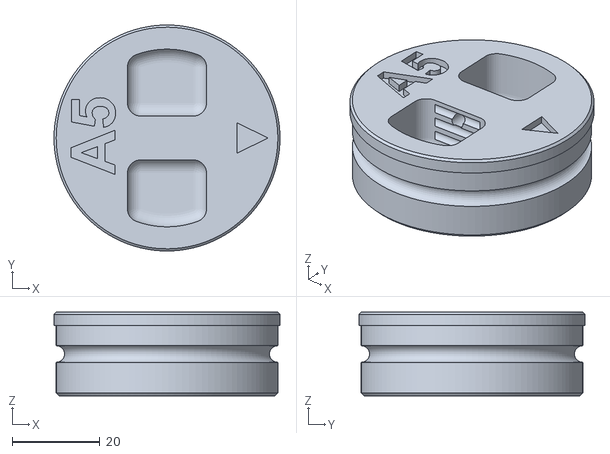
[picture p23: CAD file, 2021-11-04]
internal_buoy/o-ring_A5.stl
51.4 x 51.4 x 19.0
