RobotGrrl/EJA_v2/internal_wiper/Internal Wiper v61.step

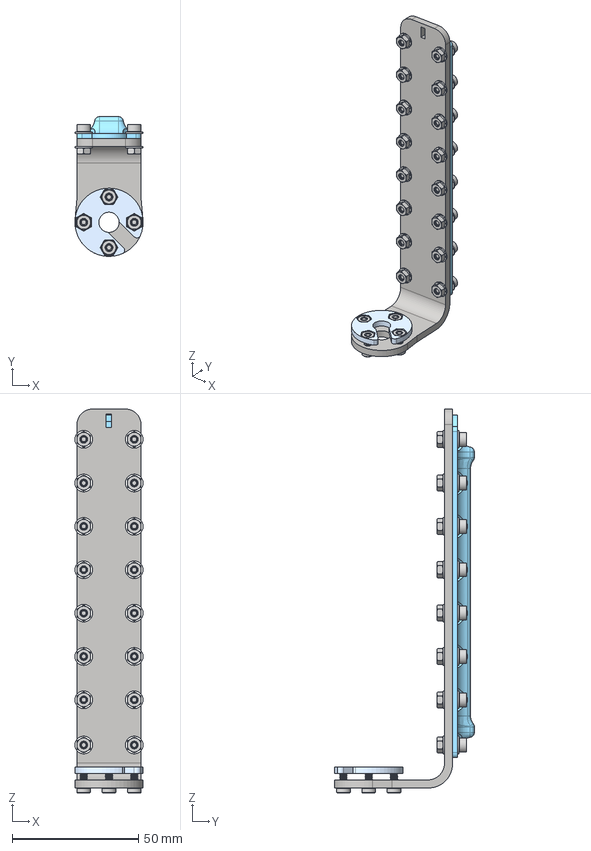
[picture p24: CAD file, 2021-11-04]
internal_wiper/Internal Wiper v61.step
27.0 x 55.3 x 152.0 mm
metal wiper
M3 thin nut 90695A033_Steel Thin Hex Nut x 4
M3x8 thin 90666A104_TYPE 316 SS LOW PROFILE x 4
brace
B 5862K116_HIGH-PULL RARE EARTH MAGNETIC DISC
magnet holder
M3 93475A210_TYPE 18-8 STAINLESS STEEL FLAT WASHER x 32
M3 90591A250_ZINC-PLATED STEEL HEX NUT x 16
M3x8 91290A113_Black-Oxide Alloy Steel Socket Head Screw x 16
