RobotGrrl/EJA_v2/lower_stage/ballast.dxf

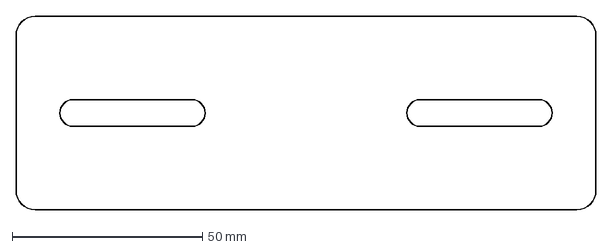
[picture p25: CAD file, 2021-11-04]
lower_stage/ballast.dxf
152.4 x 50.8 mm
