RobotGrrl/EJA_v2/magnet_holders/external_magnet_holder.stl

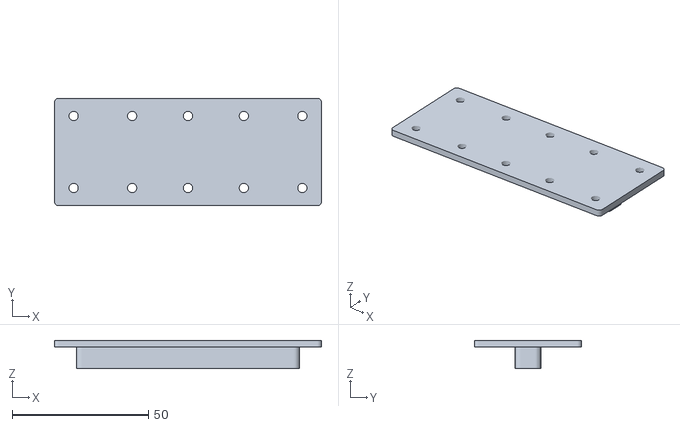
[picture p26: CAD file, 2021-11-04]
magnet_holders/external_magnet_holder.stl
97.9 x 39.4 x 10.4
