RobotGrrl/EJA_v2/servo_module/bracket_mate.stl

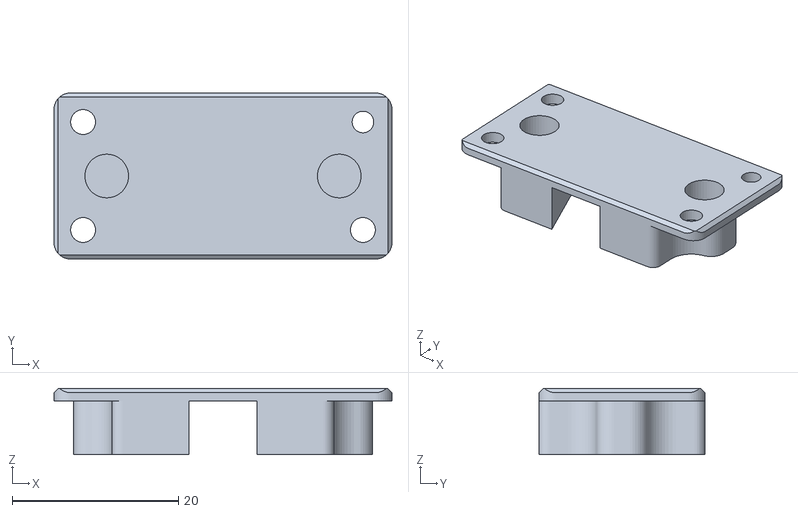
[picture p27: CAD file, 2021-11-04]
servo_module/bracket_mate.stl
40.7 x 20.0 x 7.95
