RobotGrrl/EJA_v2/servo_module/v1/servo_mag_block_r.stl

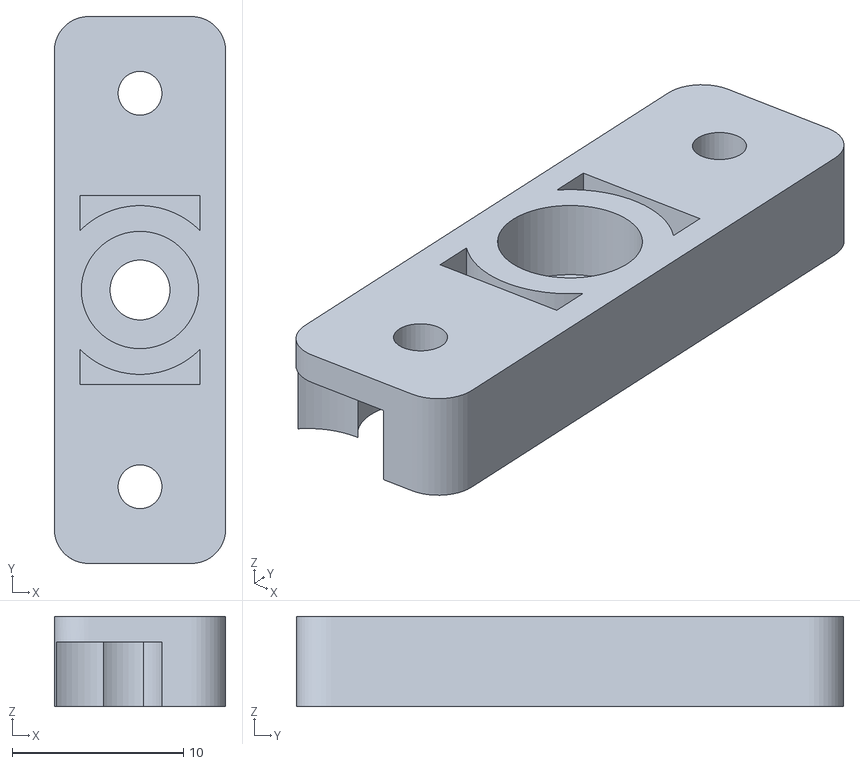
[picture p28: CAD file, 2021-11-04]
servo_module/v1/servo_mag_block_r.stl
10.0 x 31.9 x 5.28
