RobotGrrl/EJA_v2/base_stage/optional_metal_L.stl

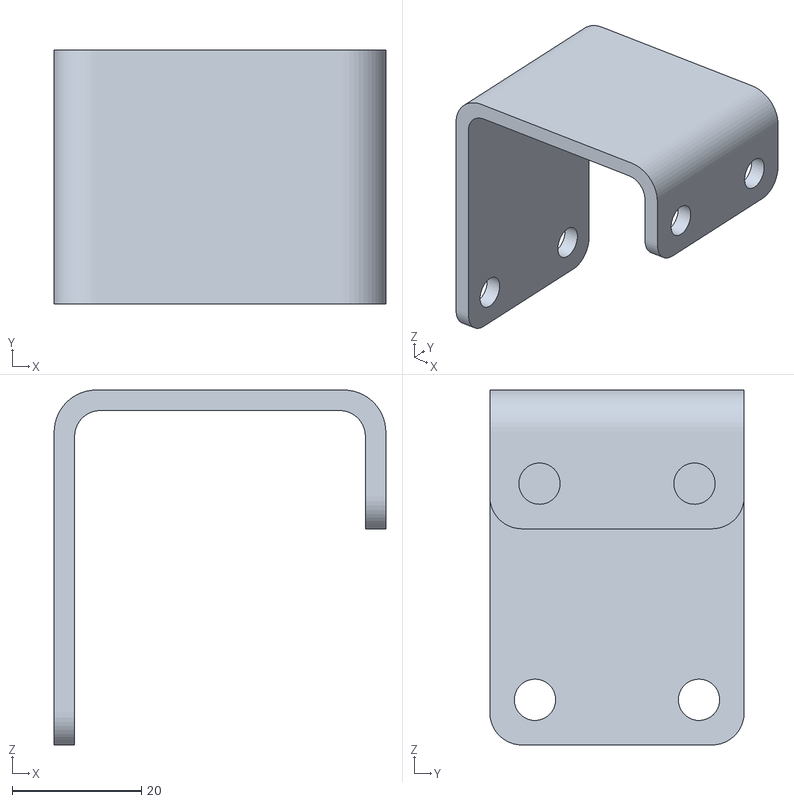
[picture p29: CAD file, 2021-11-04]
base_stage/optional_metal_L.stl
51.4 x 39.4 x 55.0
