RobotGrrl/EJA_v2/external_buoy/Buoy External v28.step

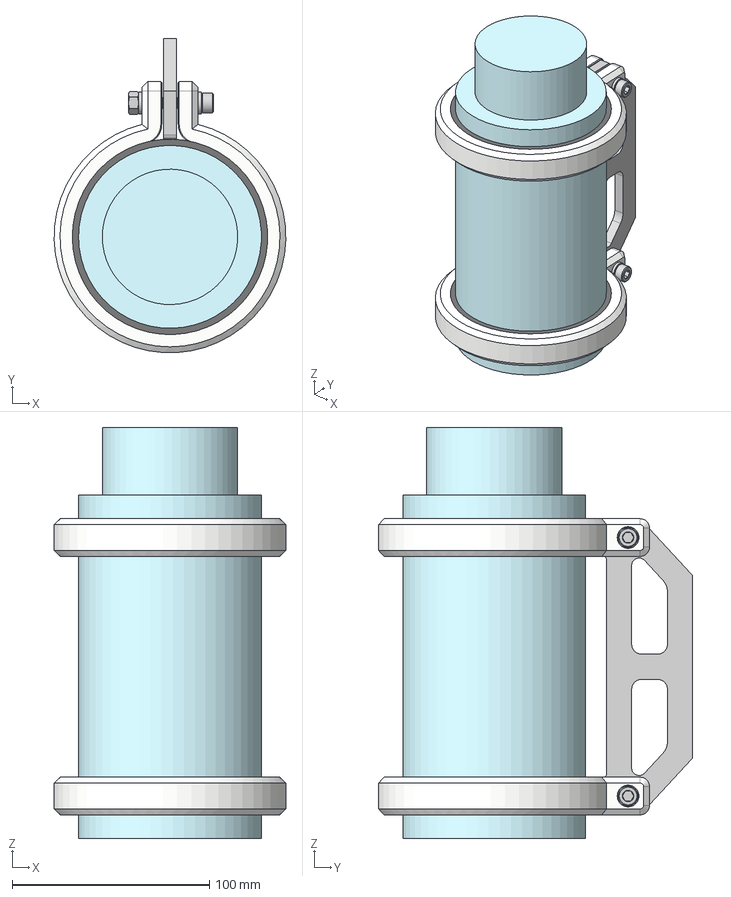
[picture p30: CAD file, 2021-11-04]
external_buoy/Buoy External v28.step
117.4 x 159.1 x 208.2 mm
Nalgene bottle v6
compressible foam 7503N61
clamp
compressible foam 7503N61 (Mirror)
clamp(Mirror)
handle
M6 98688A116_ METRIC GENERAL PURPOSE WASHERS x 4
M6 90591A151_ZINC-PLATED STEEL HEX NUT x 2
M6x35 90128A267_Zinc-Plated Alloy Steel Socket Head Screw x 2
