RobotGrrl/EJA_v2/external_wiper/metal_unfolded.dxf

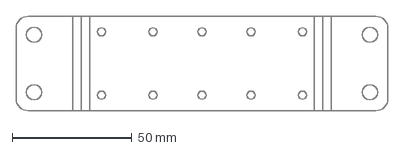
[picture p31: CAD file, 2021-11-04]
external_wiper/metal_unfolded.dxf
155.2 x 39.4 mm
