RobotGrrl/EJA_v2/internal_buoy/o-ring_milled.stl

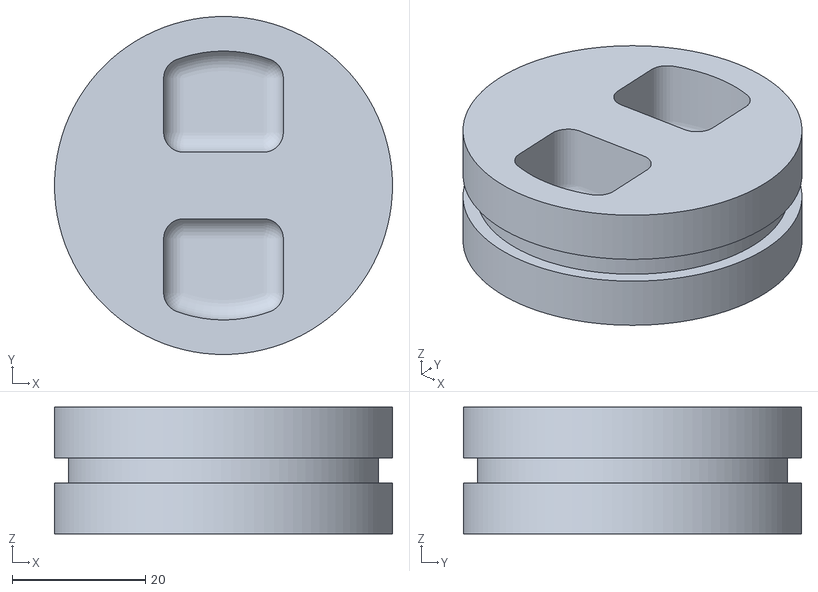
[picture p32: CAD file, 2021-11-04]
internal_buoy/o-ring_milled.stl
50.8 x 50.8 x 19.0
