RobotGrrl/EJA_v2/internal_wiper/metal_wiper_a.dxf

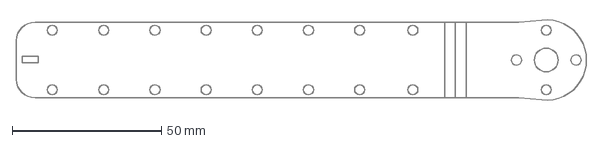
[picture p33: CAD file, 2021-11-04]
internal_wiper/metal_wiper_a.dxf
191.9 x 28.0 mm
