RobotGrrl/EJA_v2/lower_stage/lower_stage_base.dxf

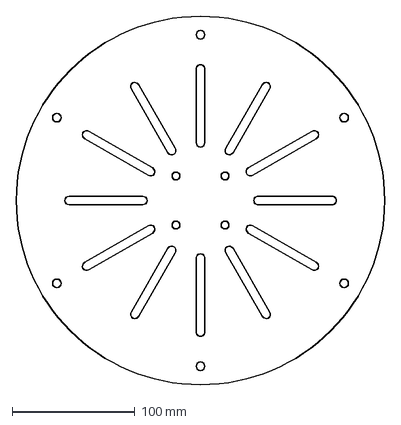
[picture p34: CAD file, 2021-11-04]
lower_stage/lower_stage_base.dxf
300.0 x 300.0 mm
