RobotGrrl/EJA_v2/magnet_holders/Buoy Combined - Magnet Wipers v15.step

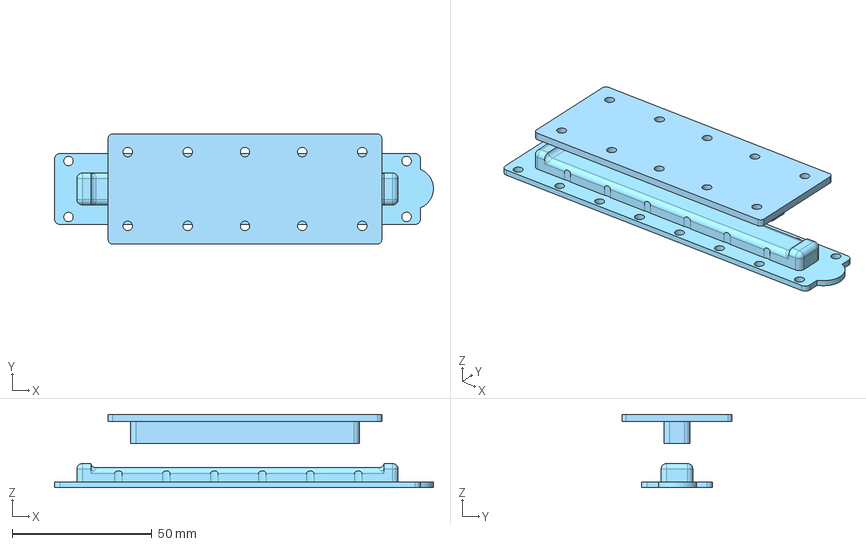
[picture p35: CAD file, 2021-11-04]
magnet_holders/Buoy Combined - Magnet Wipers v15.step
135.6 x 39.4 x 26.3 mm
external template
3/4" x 1/4"
internal template
