RobotGrrl/EJA_v2/servo_module/bracket_mount.stl

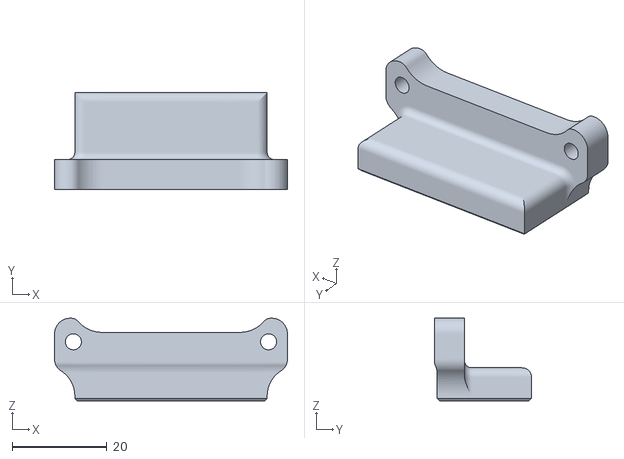
[picture p36: CAD file, 2021-11-04]
servo_module/bracket_mount.stl
49.3 x 20.5 x 17.5
