RobotGrrl/EJA_v2/servo_module/v1/Servo block R5 v10.step

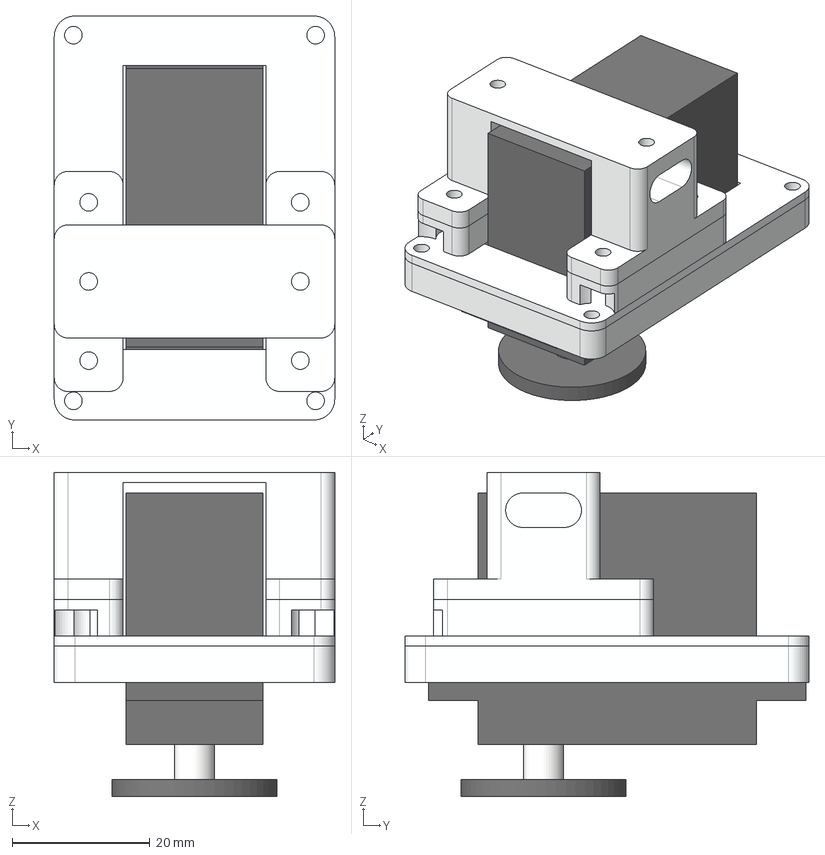
[picture p37: CAD file, 2021-11-04]
servo_module/v1/Servo block R5 v10.step
40.7 x 58.6 x 47.1 mm
MG995 v1 (1)
bracket front
bracket back
mag block 1
mag bracket
mag block 1(Mirror)
mag lid 1(Mirror)
