RobotGrrl/EJA_v2/base_stage/spool_holder.stl

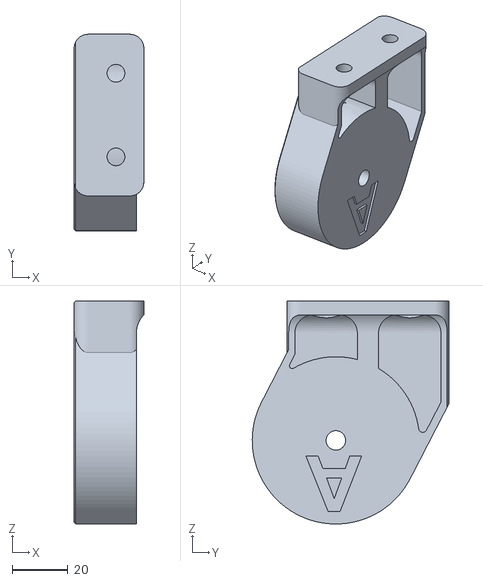
[picture p38: CAD file, 2021-11-04]
base_stage/spool_holder.stl
25.0 x 70.5 x 80.0
