RobotGrrl/EJA_v2/external_buoy/foam.dxf

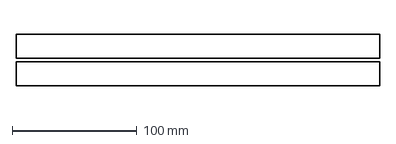
[picture p39: CAD file, 2021-11-04]
external_buoy/foam.dxf
291.0 x 41.1 mm
