RobotGrrl/EJA_v2/external_wiper/Buoy External Wiper v87.step

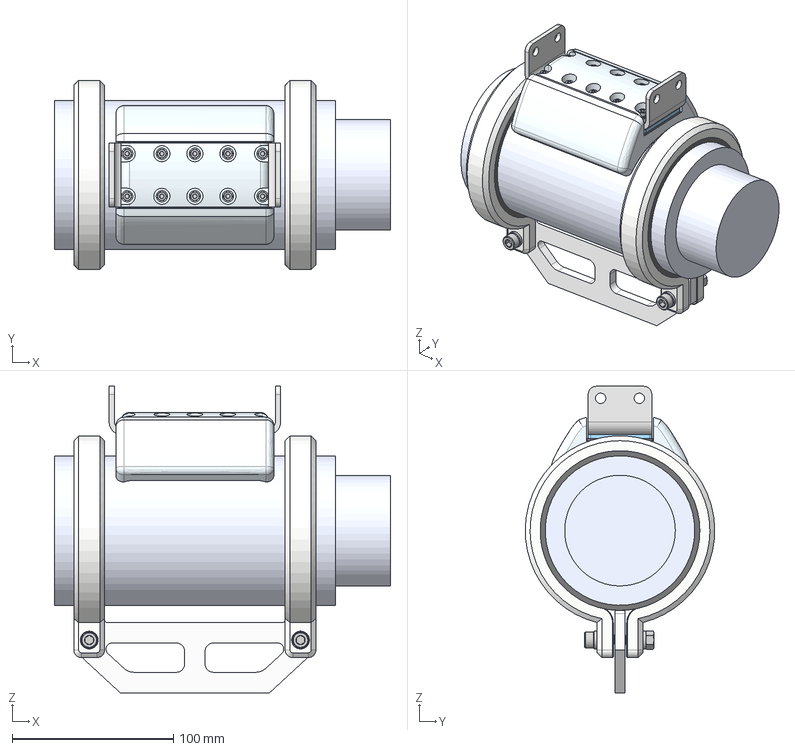
[picture p40: CAD file, 2021-11-04]
external_wiper/Buoy External Wiper v87.step
208.2 x 117.4 x 190.0 mm
Nalgene bottle v6
compressible foam 7503N61
clamp
compressible foam 7503N61 (Mirror)
clamp(Mirror)
handle
M6 98688A116_ METRIC GENERAL PURPOSE WASHERS x 4
M6 90591A151_ZINC-PLATED STEEL HEX NUT x 2
M6x35 90128A267_Zinc-Plated Alloy Steel Socket Head Screw x 2
seatbelt
metal
magnet holder
cap
M3 93475A210_TYPE 18-8 STAINLESS STEEL FLAT WASHER x 10
M3 x 16 mm 91290A120_Black-Oxide Alloy Steel x 10
M3 94180A331_HEAT-SET INSERTS FOR PLASTICS x 10
gasket
