RobotGrrl/EJA_v2/internal_buoy/metal_bracket_unfolded.dxf

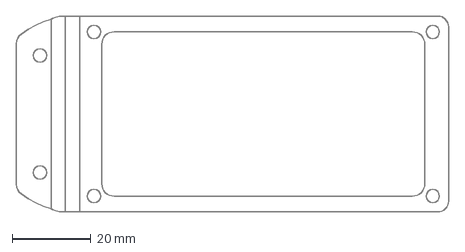
[picture p41: CAD file, 2021-11-04]
internal_buoy/metal_bracket_unfolded.dxf
109.7 x 49.7 mm
