RobotGrrl/EJA_v2/internal_wiper/brace.stl

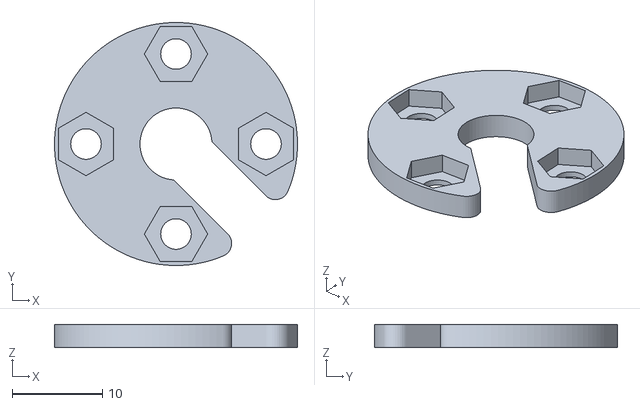
[picture p42: CAD file, 2021-11-04]
internal_wiper/brace.stl
27.0 x 27.0 x 2.60
