RobotGrrl/EJA_v2/lower_stage/stand.stl

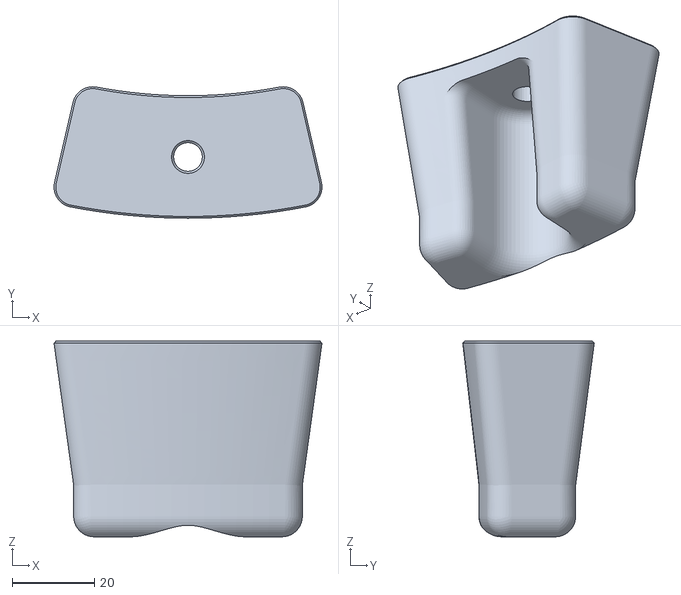
[picture p43: CAD file, 2021-11-04]
lower_stage/stand.stl
65.3 x 32.1 x 47.7
