RobotGrrl/EJA_v2/servo_module/bracket_key.stl

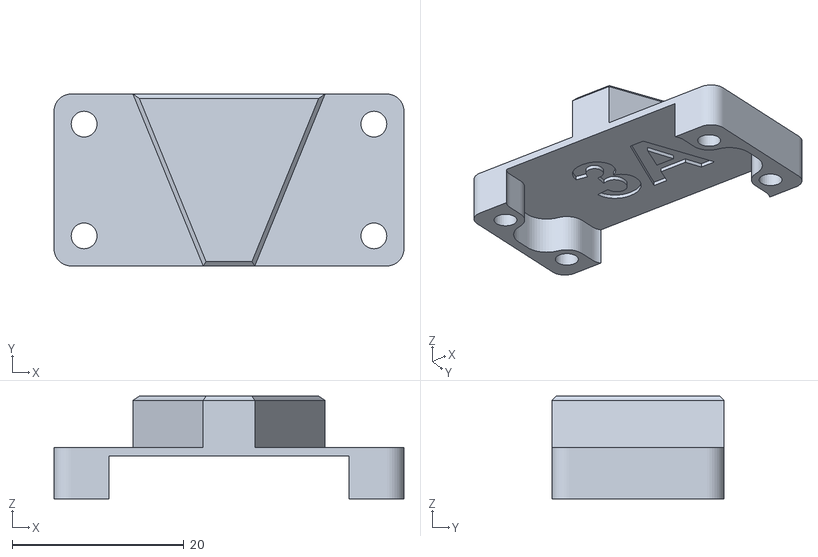
[picture p44: CAD file, 2021-11-04]
servo_module/bracket_key.stl
40.7 x 20.0 x 11.9
