RobotGrrl/EJA_v2/servo_module/v1/servo_bracket_front.stl

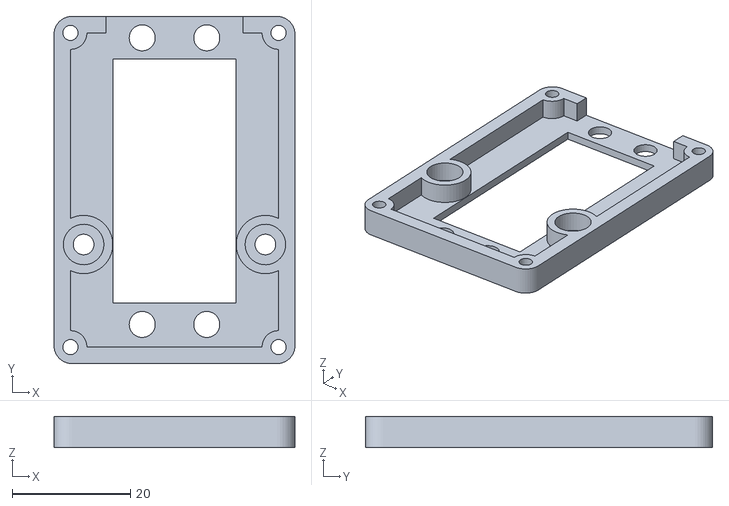
[picture p45: CAD file, 2021-11-04]
servo_module/v1/servo_bracket_front.stl
40.7 x 58.6 x 5.27
