RobotGrrl/EJA_v2/base_stage/holder_mirror.stl

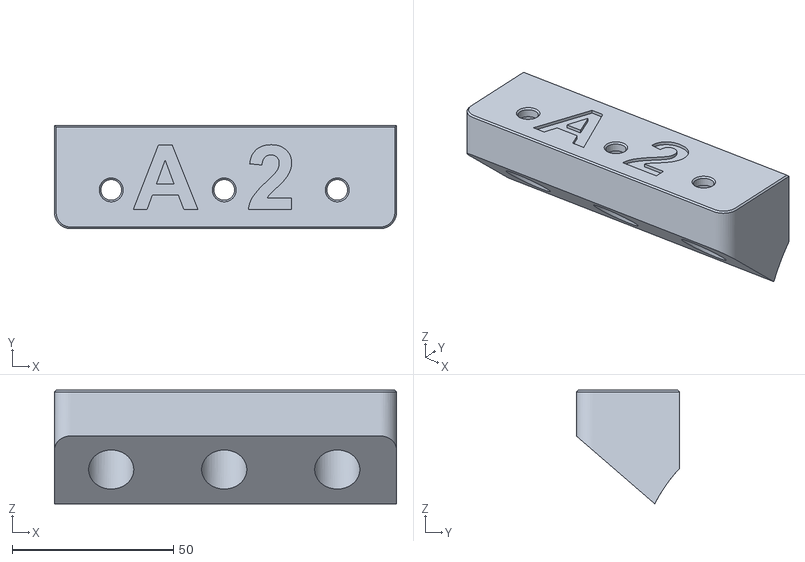
[picture p46: CAD file, 2021-11-04]
base_stage/holder_mirror.stl
105.9 x 32.0 x 35.2
