RobotGrrl/EJA_v2/external_buoy/clamp_A4.stl

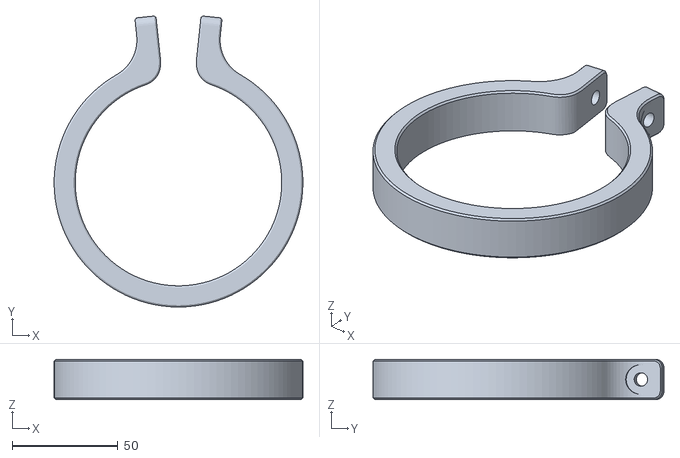
[picture p47: CAD file, 2021-11-04]
external_buoy/clamp_A4.stl
117.4 x 137.4 x 19.0
