RobotGrrl/EJA_v2/external_wiper/seatbelt.stl

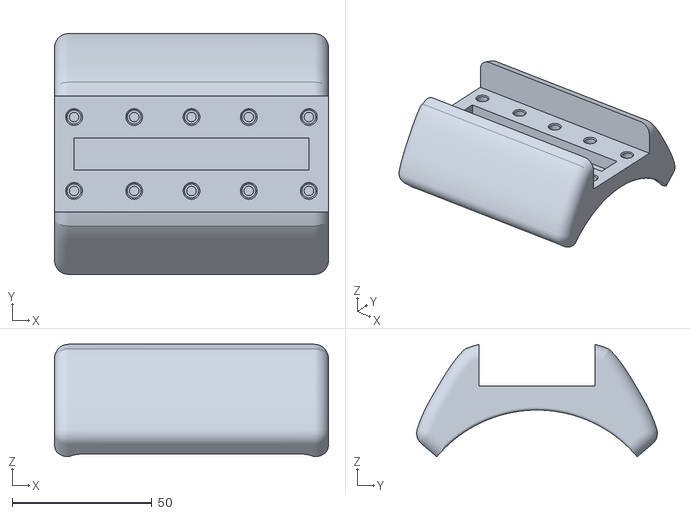
[picture p48: CAD file, 2021-11-04]
external_wiper/seatbelt.stl
97.9 x 86.0 x 40.2
