RobotGrrl/EJA_v2/internal_buoy/metal_bracket.stl

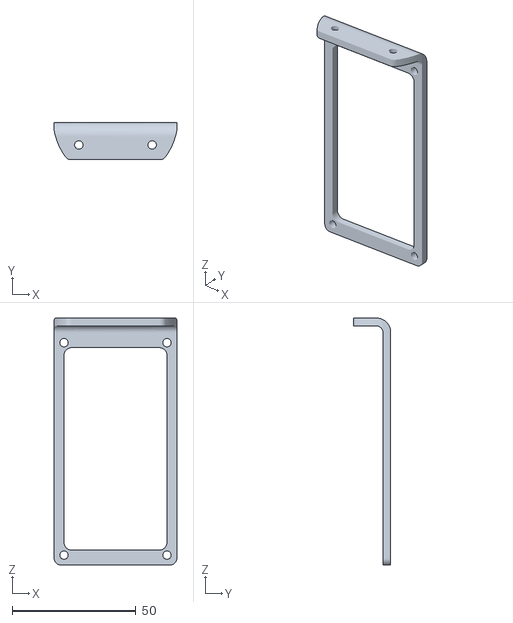
[picture p49: CAD file, 2021-11-04]
internal_buoy/metal_bracket.stl
49.7 x 15.2 x 100.0
