RobotGrrl/EJA_v2/internal_wiper/metal_wiper_c.dxf

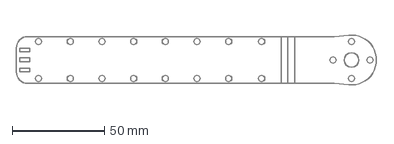
[picture p50: CAD file, 2021-11-04]
internal_wiper/metal_wiper_c.dxf
195.9 x 28.0 mm
