RobotGrrl/EJA_v2/servo_module/bracket_back.stl

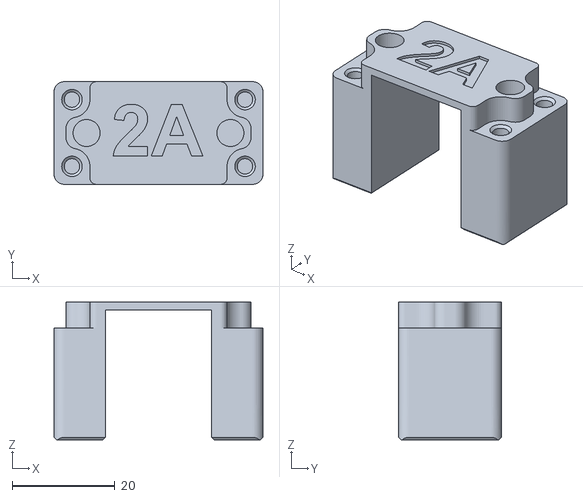
[picture p51: CAD file, 2021-11-04]
servo_module/bracket_back.stl
40.7 x 20.0 x 26.8
