RobotGrrl/EJA_v2/external_wiper/cap.stl

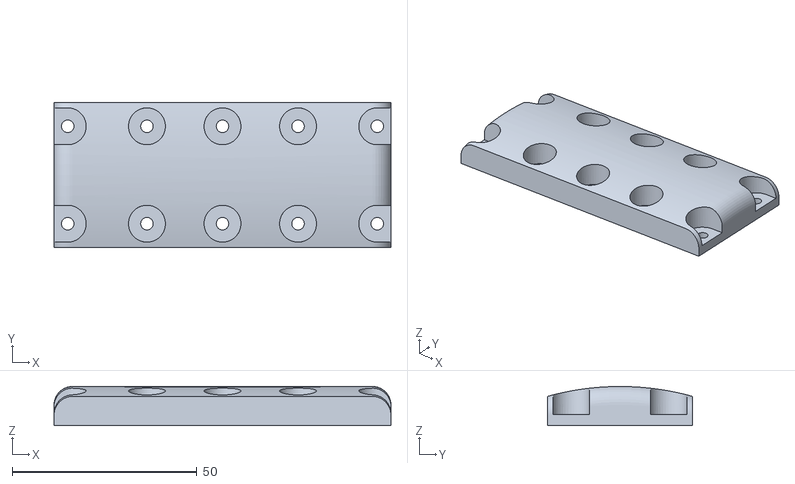
[picture p52: CAD file, 2021-11-04]
external_wiper/cap.stl
91.3 x 39.4 x 10.6
