RobotGrrl/EJA_v2/internal_buoy/o-ring_1:8_internal_milled_jig.dxf

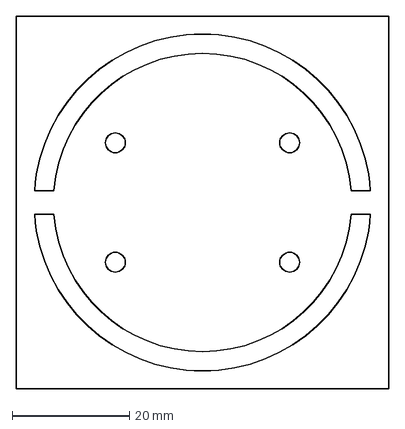
[picture p53: CAD file, 2021-11-04]
internal_buoy/o-ring_1:8_internal_milled_jig.dxf
63.5 x 63.5 mm
