RobotGrrl/EJA_v2/internal_wiper/metal_wiper_d.dxf

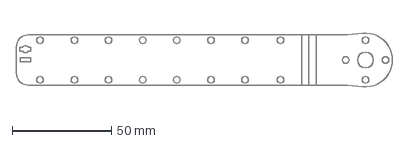
[picture p54: CAD file, 2021-11-04]
internal_wiper/metal_wiper_d.dxf
189.9 x 28.0 mm
