RobotGrrl/EJA_v2/lower_stage/lower_stage_bumper.dxf

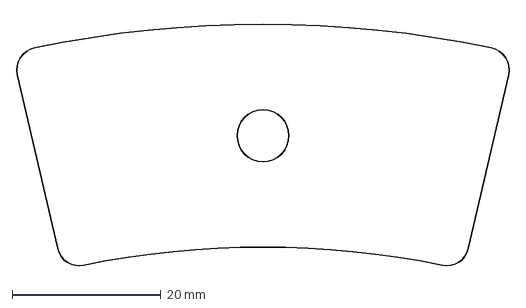
[picture p55: CAD file, 2021-11-04]
lower_stage/lower_stage_bumper.dxf
66.5 x 33.8 mm
