RobotGrrl/EJA_v2/servo_module/v1/servo_mag_bracket.stl

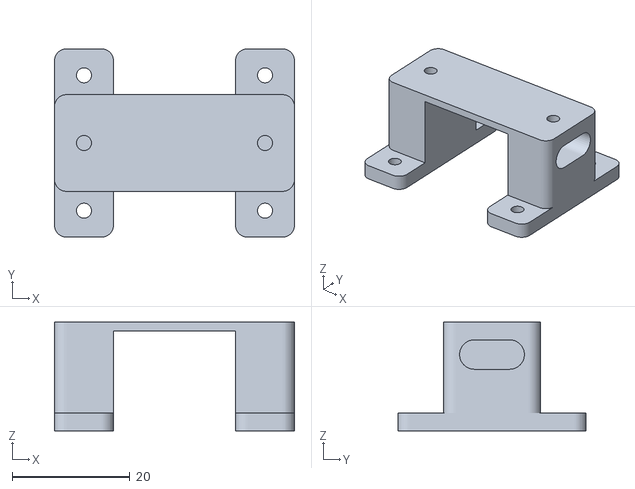
[picture p56: CAD file, 2021-11-04]
servo_module/v1/servo_mag_bracket.stl
40.7 x 31.9 x 18.5
