RobotGrrl/EJA_v2/base_stage/rope_guide_unfolded.dxf

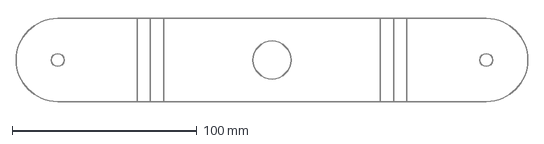
[picture p57: CAD file, 2021-11-04]
base_stage/rope_guide_unfolded.dxf
277.2 x 45.0 mm
