RobotGrrl/EJA_v2/external_wiper/metal.stl

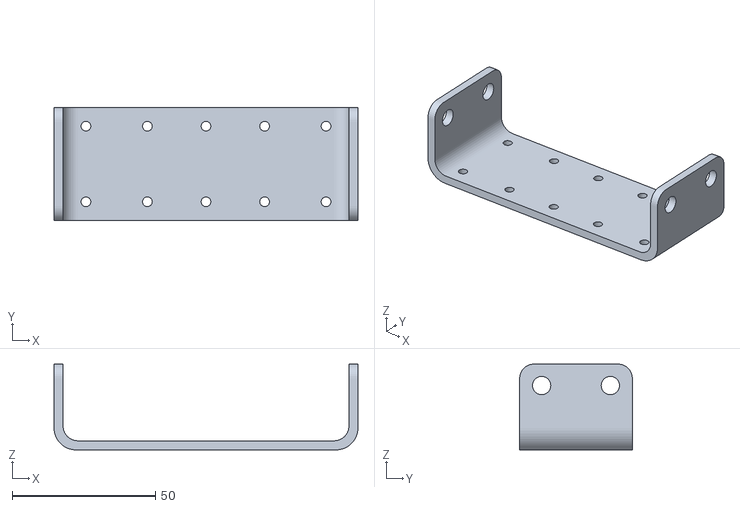
[picture p58: CAD file, 2021-11-04]
external_wiper/metal.stl
106.2 x 39.4 x 30.0
