RobotGrrl/EJA_v2/internal_wiper/metal_wiper_b.dxf

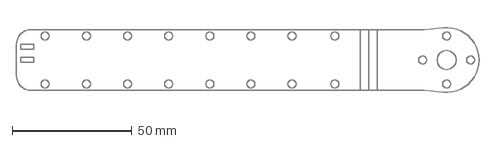
[picture p59: CAD file, 2021-11-04]
internal_wiper/metal_wiper_b.dxf
193.9 x 28.0 mm
