RobotGrrl/EJA_v2/base_stage/sleeve_base_bracket.stl

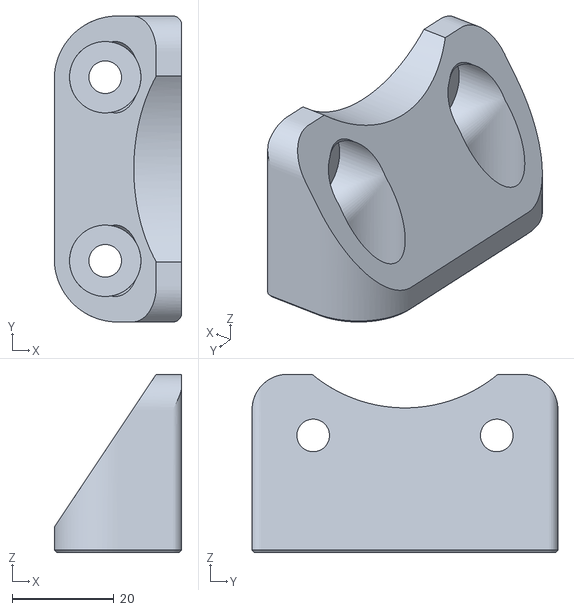
[picture p60: CAD file, 2021-11-04]
base_stage/sleeve_base_bracket.stl
25.0 x 60.0 x 35.0
