RobotGrrl/EJA_v2/base_stage/hdpe_handle.dxf

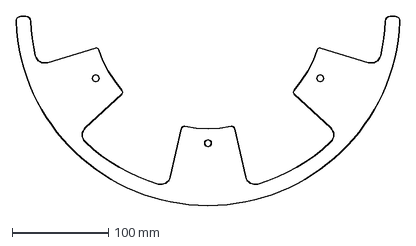
[picture p61: CAD file, 2021-11-04]
base_stage/hdpe_handle.dxf
399.8 x 197.0 mm
