RobotGrrl/EJA_v2/base_stage/arm.dxf

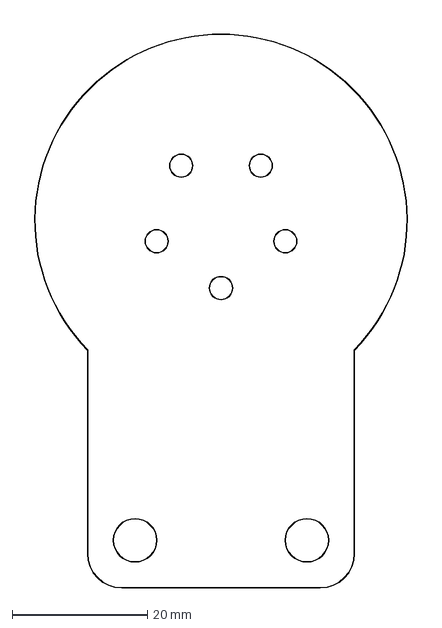
[picture p62: CAD file, 2021-11-04]
base_stage/arm.dxf
60.5 x 84.4 mm
