RobotGrrl/EJA_v2/base_stage/rope_guide.stl

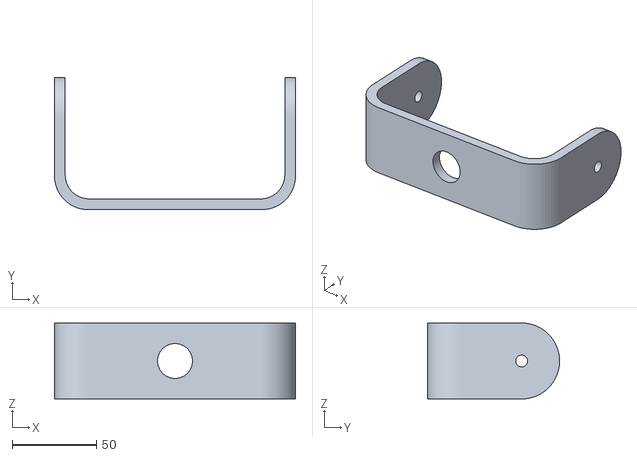
[picture p63: CAD file, 2021-11-04]
base_stage/rope_guide.stl
142.7 x 78.3 x 45.0
