RobotGrrl/EJA_v2/base_stage/sleeve.dxf

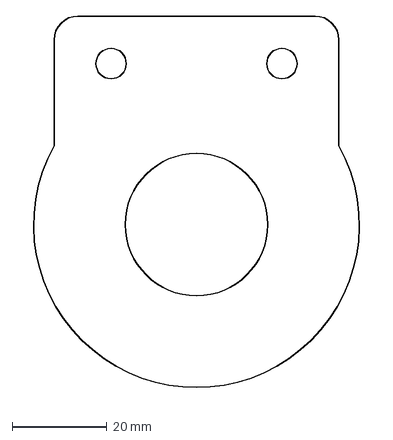
[picture p64: CAD file, 2021-11-04]
base_stage/sleeve.dxf
76.0 x 80.8 mm
