RobotGrrl/EJA_v2/base_stage/optional_metal_R.stl

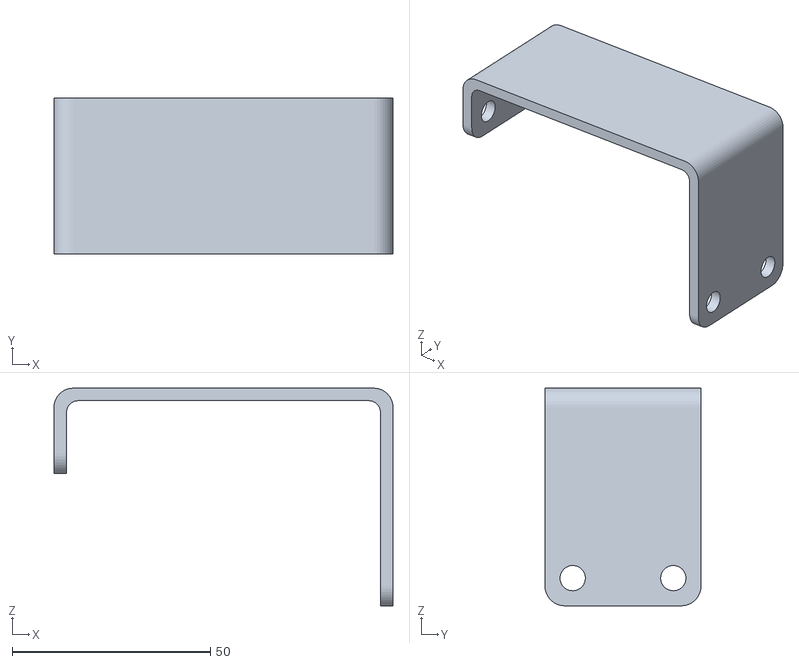
[picture p65: CAD file, 2021-11-04]
base_stage/optional_metal_R.stl
85.6 x 39.4 x 55.0
