RobotGrrl/EJA_v2/base_stage/bumper.dxf

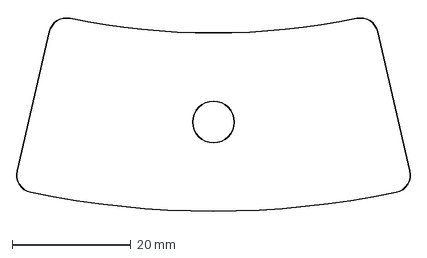
[picture p66: CAD file, 2021-11-04]
base_stage/bumper.dxf
66.5 x 33.8 mm
