RobotGrrl/EJA_v2/base_stage/base.dxf

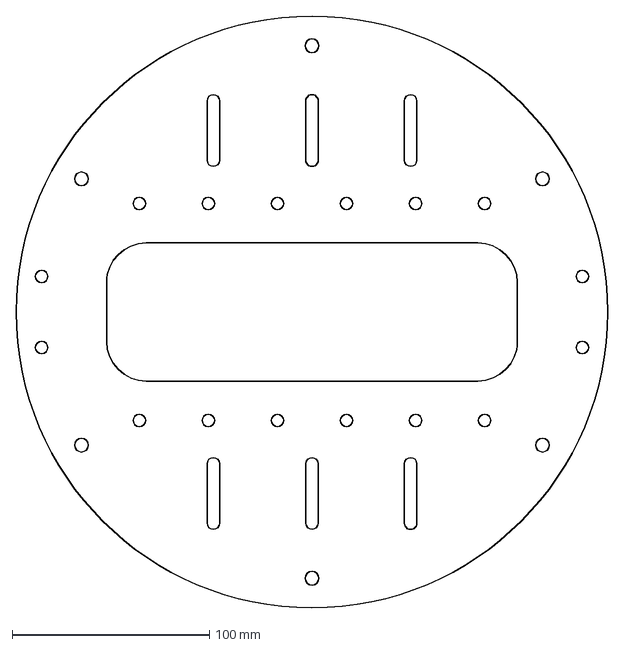
[picture p67: CAD file, 2021-11-04]
base_stage/base.dxf
300.0 x 300.0 mm
