RobotGrrl/EJA_v2/base_stage/gopro.stl

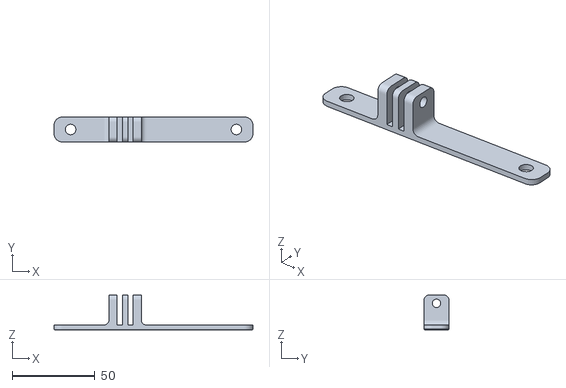
[picture p68: CAD file, 2021-11-04]
base_stage/gopro.stl
120.0 x 15.0 x 21.0
