RobotGrrl/EJA_v2/base_stage/large_rubber_belt_array.dxf

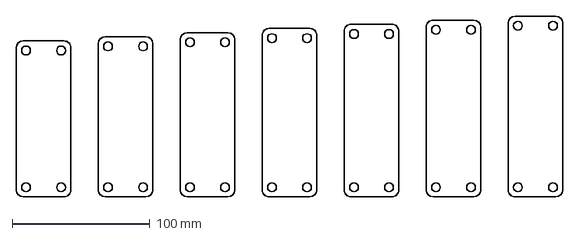
[picture p69: CAD file, 2021-11-04]
base_stage/large_rubber_belt_array.dxf
395.8 x 131.1 mm
