RobotGrrl/EJA_v2/base_stage/rotor.stl

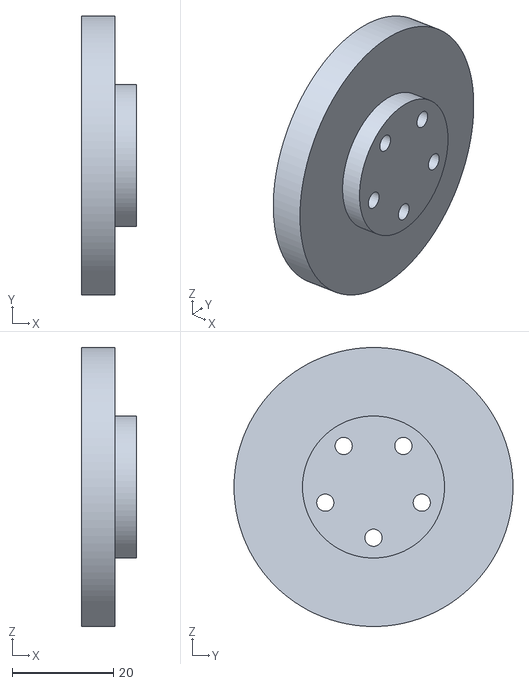
[picture p70: CAD file, 2021-11-04]
base_stage/rotor.stl
10.8 x 55.0 x 55.0
