RobotGrrl/EJA_v2/base_stage/small_rubber_belt_array.dxf

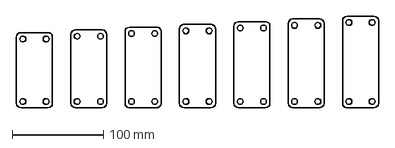
[picture p71: CAD file, 2021-11-04]
base_stage/small_rubber_belt_array.dxf
395.8 x 100.2 mm
