RobotGrrl/EJA_v2/(list of files, cad)

Other CAD files:
servo_module/v1/servo_mag_block_l.stl
base_stage/spool_holder_mirror.stl
base_stage/holder.stl
base_stage/washer.dxf
external_buoy/Buoy External v28.f3z
external_wiper/Buoy External Wiper v87.f3z
external_wiper/gasket.dxf
internal_buoy/board.dxf
lower_stage/lower_stage_washer.dxf
servo_module/Servo Module v45.f3z
servo_module/v1/Servo block R5 v10.f3z
