RobotGrrl/EJA_v2/EJA v2 BOM [FINAL] - COMPLETE FASTENER BOM.pdf

## EJA v2 Bill of Materials

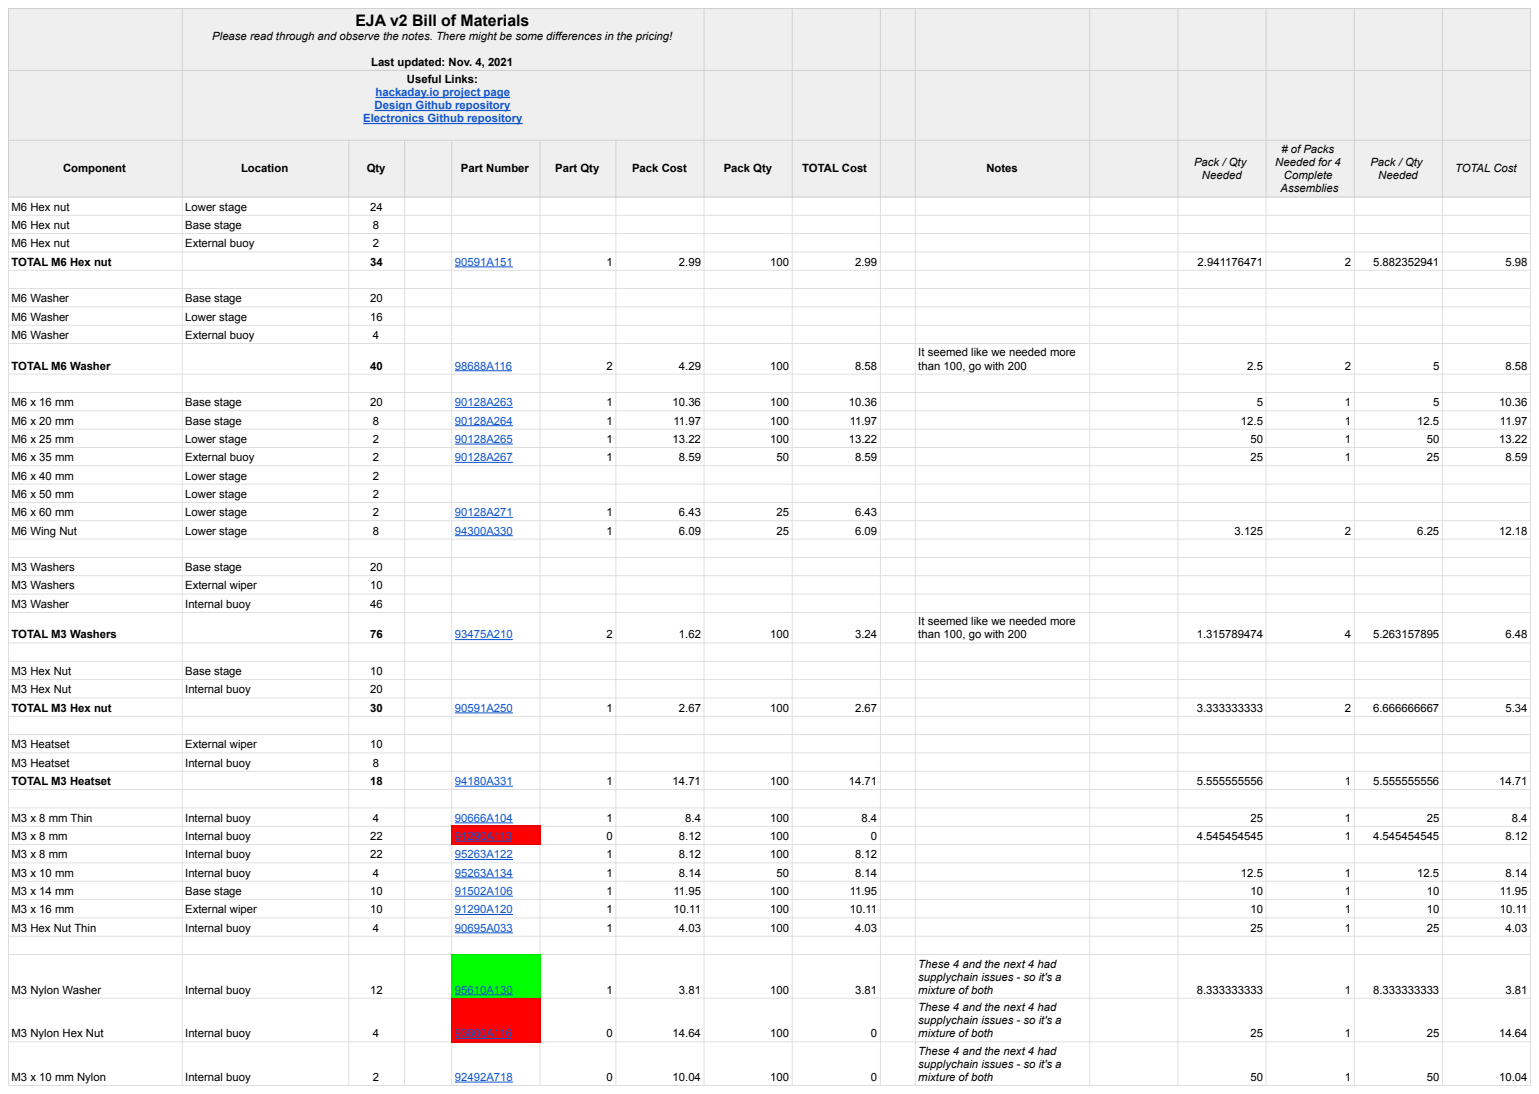
[picture p72: page 1]
Component; Location; Qty; Part Number; Part Qty; Pack Cost; Pack Qty; TOTAL Cost; Notes; Pack / Qty Needed; M6 Hex nut; Lower stage; Base stage; External buoy; TOTAL M6 Hex nut; M6 Washer; TOTAL M6 Washer; than 100, go with 200; M6 Wing Nut; M3 Washers; External wiper; M3 Washer; Internal buoy; TOTAL M3 Washers; M3 Hex Nut; TOTAL M3 Hex nut; M3 Heatset; TOTAL M3 Heatset; M3 x 8 mm Thin; M3 Hex Nut Thin; M3 Nylon Washer; M3 Nylon Hex Nut; M3 x 10 mm Nylon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

Please read through and observe the notes. There might be some differences in the pricing!

Last updated: Nov. 4, 2021
Useful Links: hackaday.io project page

Design Github repository
Electronics Github repository

# of Packs Needed for 4 Complete Assemblies

It seemed like we needed more

These 4 and the next 4 had supplychain issues - so it's a mixture of both 8.333333333 1 8.333333333 3.81

These 4 and the next 4 had supplychain issues - so it's a mixture of both 25 1 25 14.64

These 4 and the next 4 had

| EJA v2 Bill of Materials Please read through and observe the notes. There might be some differences in the pricing! Last updated: Nov. 4, 2021

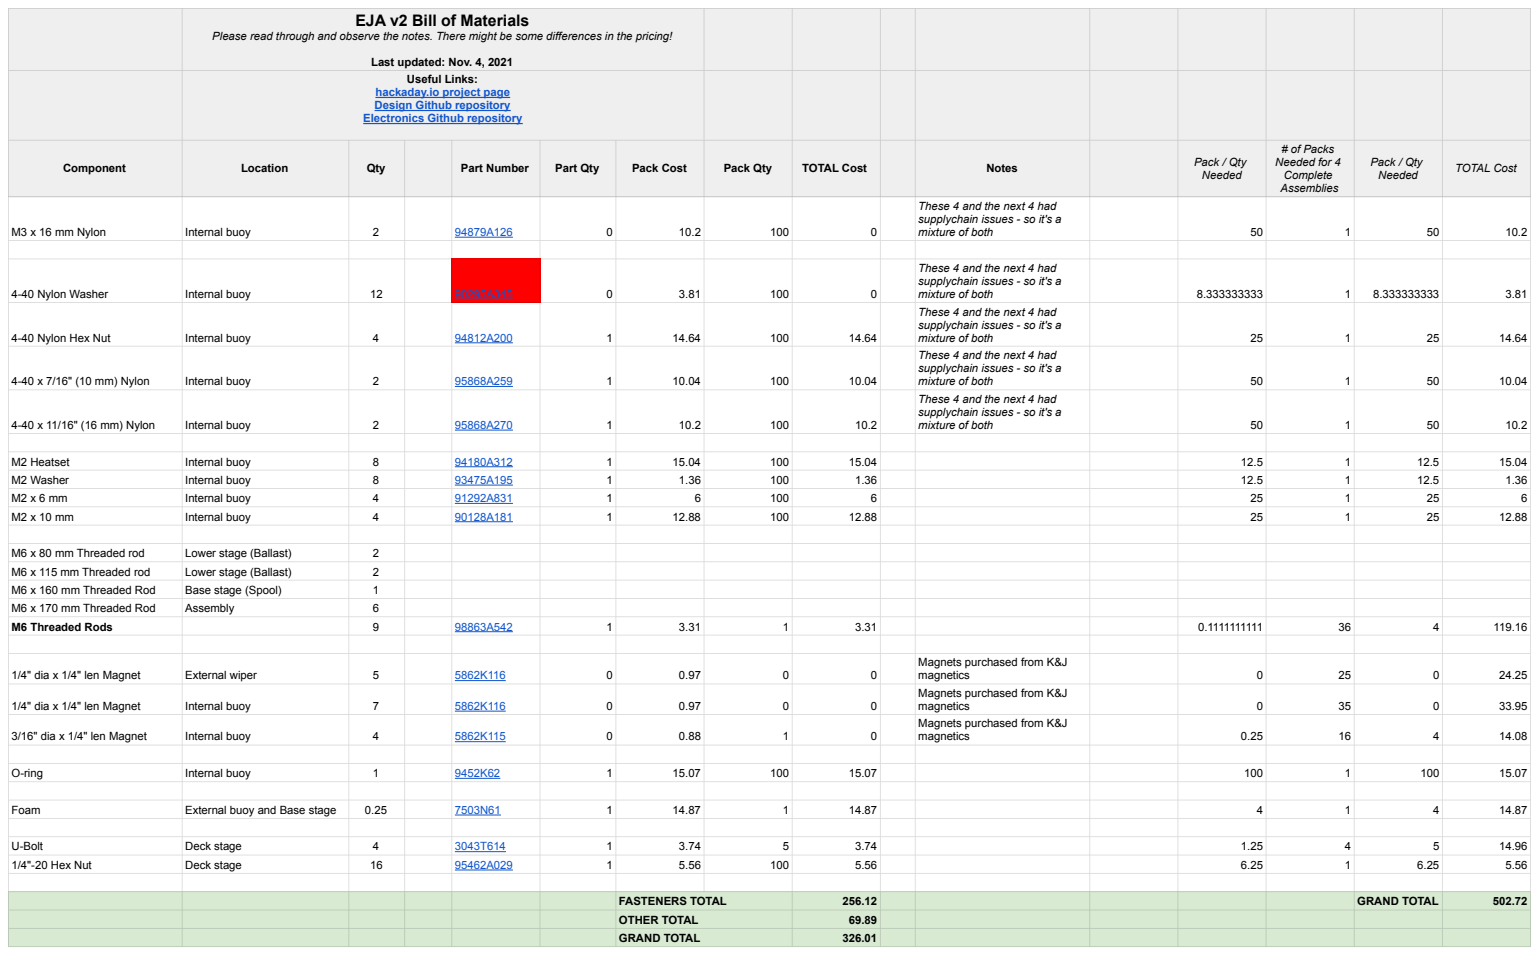
[picture p73: page 2]
M3 x 16 mm Nylon; Internal buoy; supplychain issues - so it's a mixture of both; 4-40 Nylon Washer; 4-40 Nylon Hex Nut; 4-40 x 7/16" (10 mm) Nylon; 4-40 x 11/16" (16 mm) Nylon; M2 Heatset; M2 Washer; M6 x 80 mm Threaded rod; Lower stage (Ballast); M6 x 115 mm Threaded rod; M6 x 160 mm Threaded Rod; Base stage (Spool); M6 x 170 mm Threaded Rod; Assembly; M6 Threaded Rods; 1/4" dia x 1/4" len Magnet; External wiper; magnetics; 3/16" dia x 1/4" len Magnet; O-ring; Foam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

Useful Links: hackaday.io project page Design Github repository Electronics Github repository

Component | Location | Qty | Part Number | Part Qty | Pack Cost | Pack Qty | TOTAL Cost | Notes | Pack / Qty Needed | # of Packs Needed for 4 Complete Assemblies | Pack / Qty Needed | TOTAL Cost

These 4 and the next 4 had

Magnets purchased from K&J
