RobotGrrl/EJA_v2/internal_buoy/Board Bracket Drawing.pdf

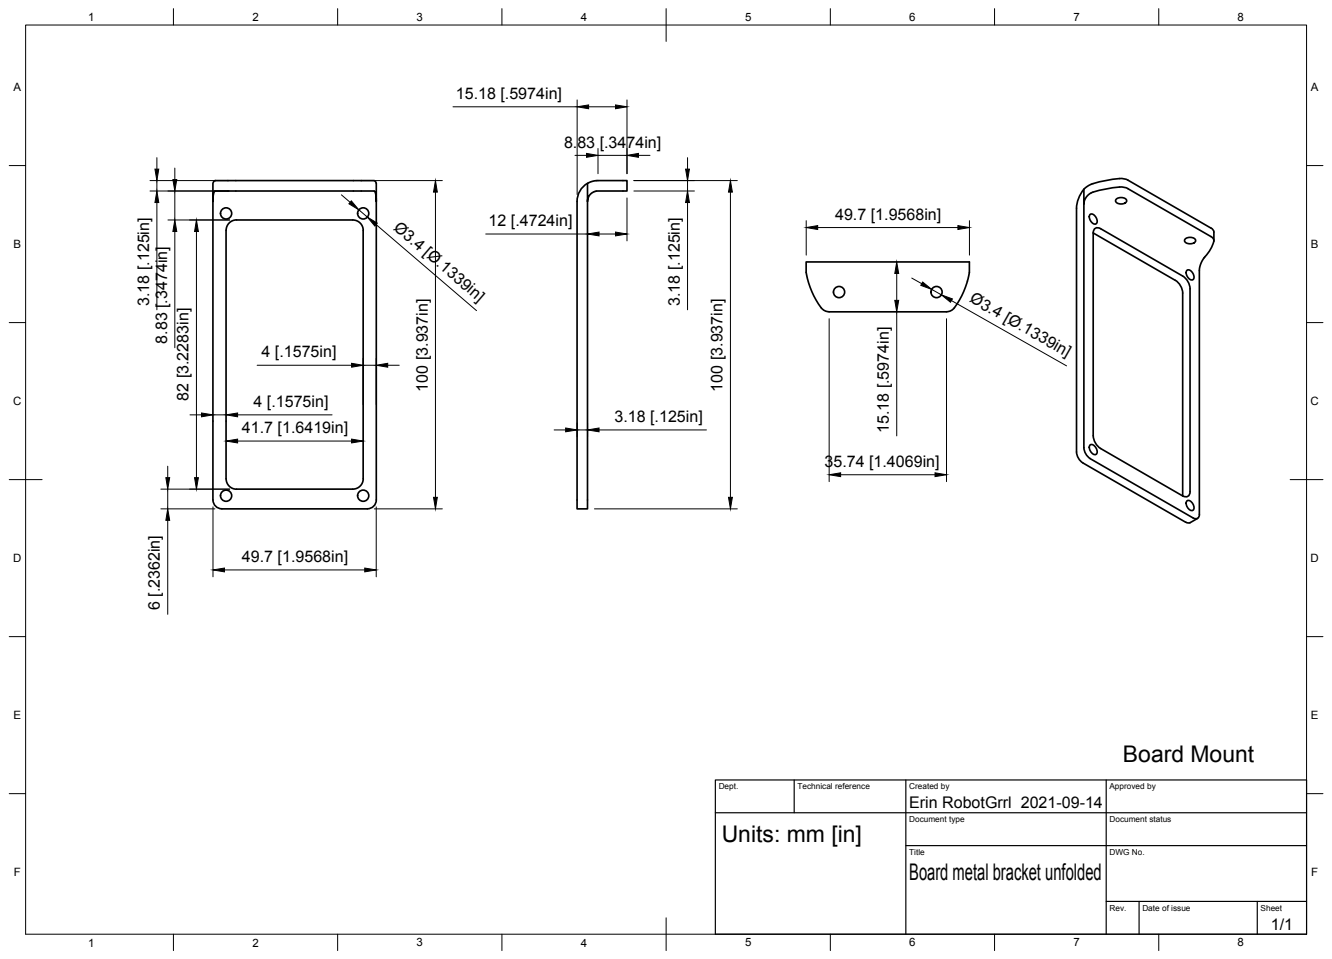
[picture p74: page 1]
Title; DWG No.; Rev.; Date of issue; Sheet; Board Mount

Dept. | Technical reference | Created by Erin RobotGrrl 2021-09-14 | Approved by

Document type | Document status

Units: mm [in]

Board metal bracket unfolded
