RobotGrrl/EJA_v2/internal_buoy/Bracket - Board A Boundaries Drawing v5.pdf

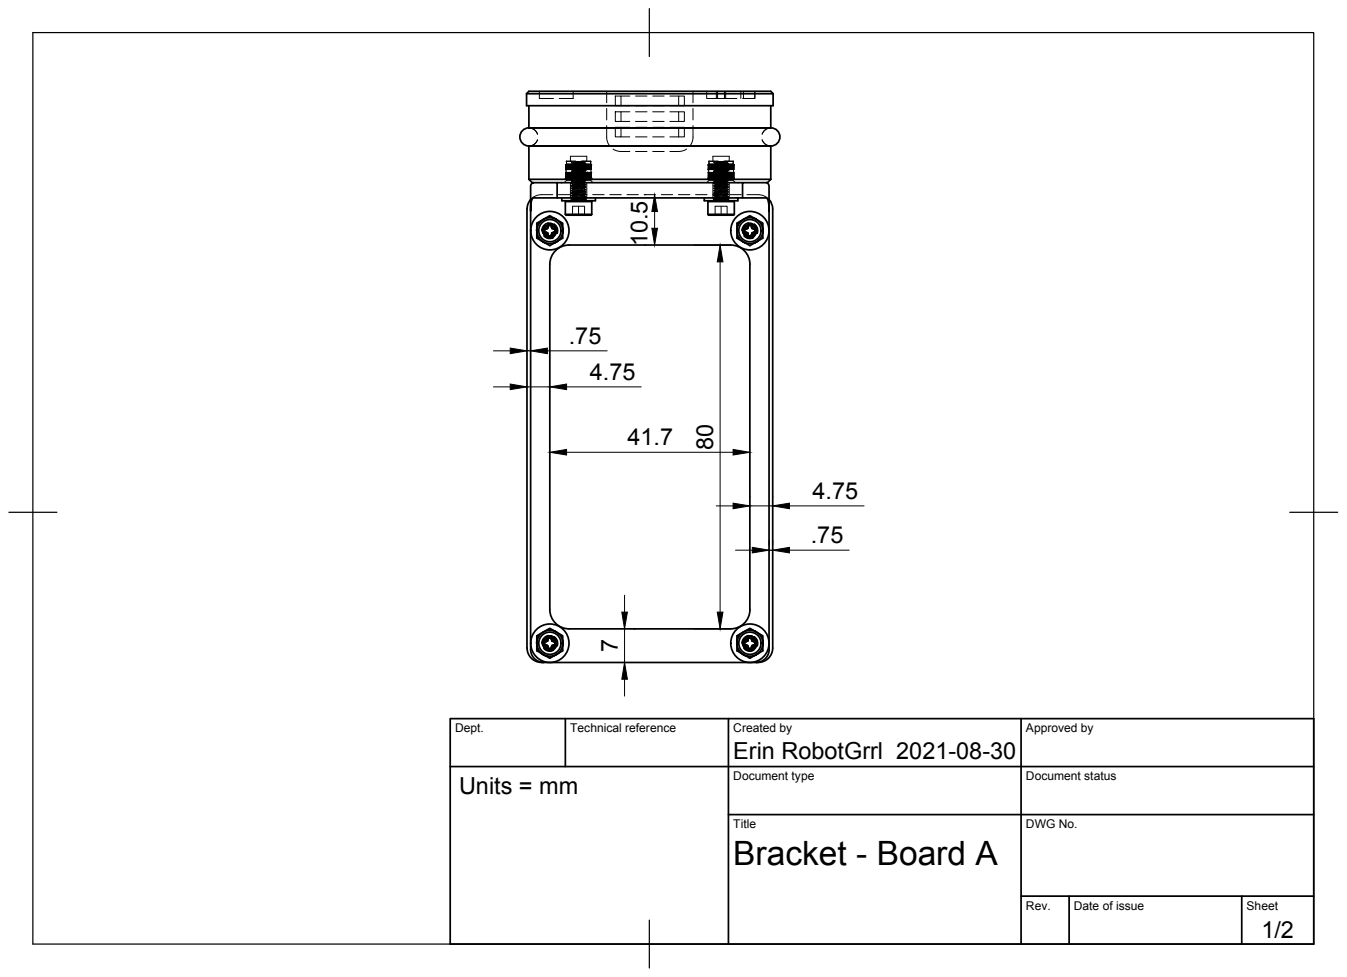
[picture p75: page 1]

Dept. | Technical reference | Created by Erin RobotGrrl 2021-08-30 | Approved by

Units = mm | | Document type | Document status

Title Bracket - Board A | DWG No.

Rev. | Date of issue | Sheet 1/2

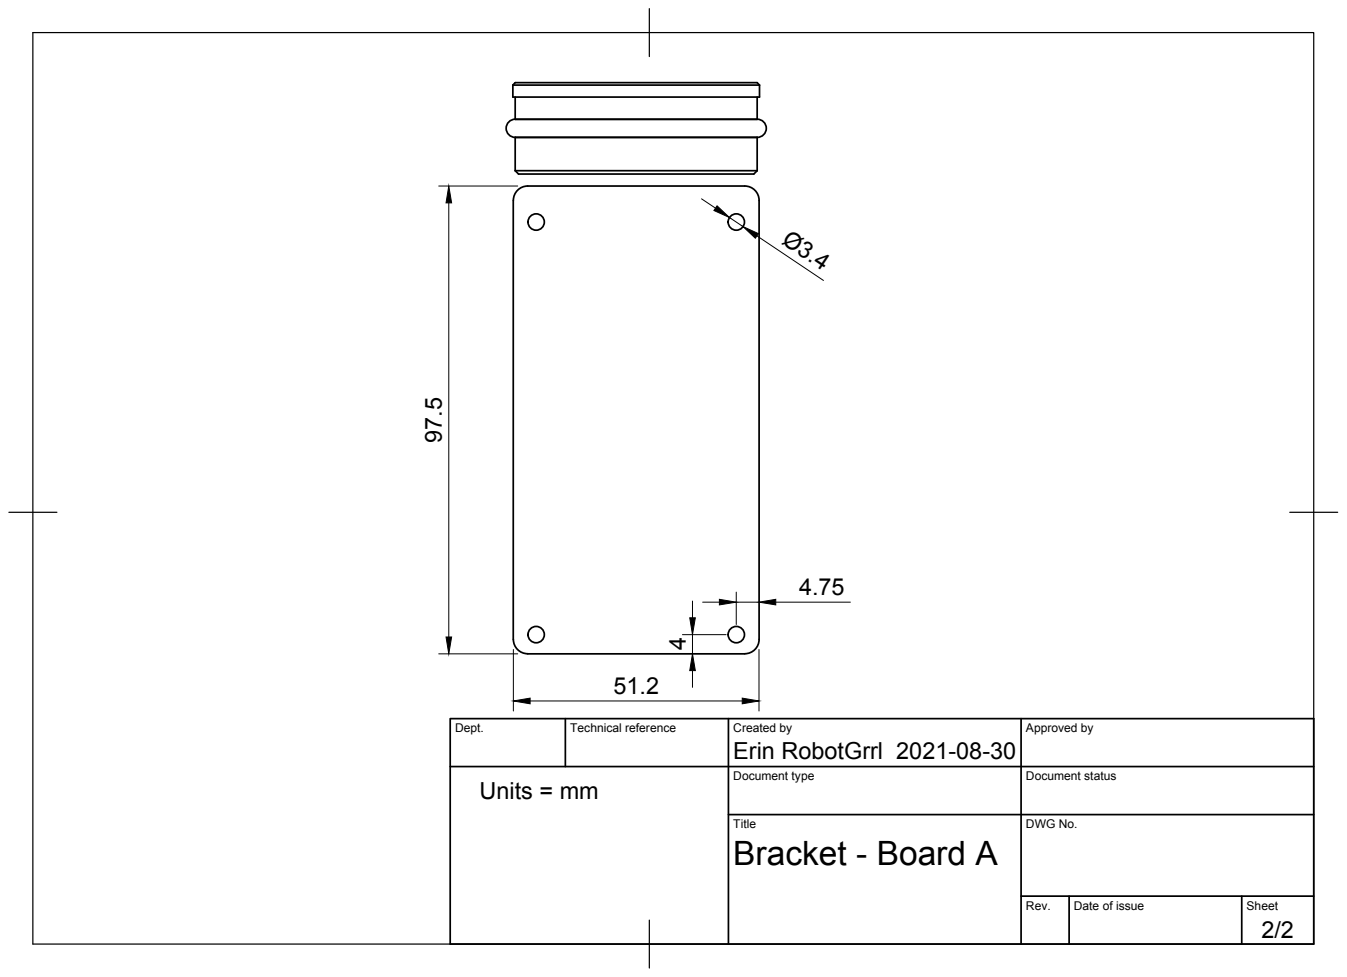
[picture p76: page 2]
Erin RobotGrrl 97.5

Dept. | Technical reference | Created by 2021-08-30 | Approved by

Units = mm | | Document type | Document status

Title Bracket - Board A | DWG No.

Rev. | Date of issue | Sheet 2/2
