RobotGrrl/EJA_v2/internal_buoy/O-ring 1:8 Internal - Milled Drawing v1.pdf

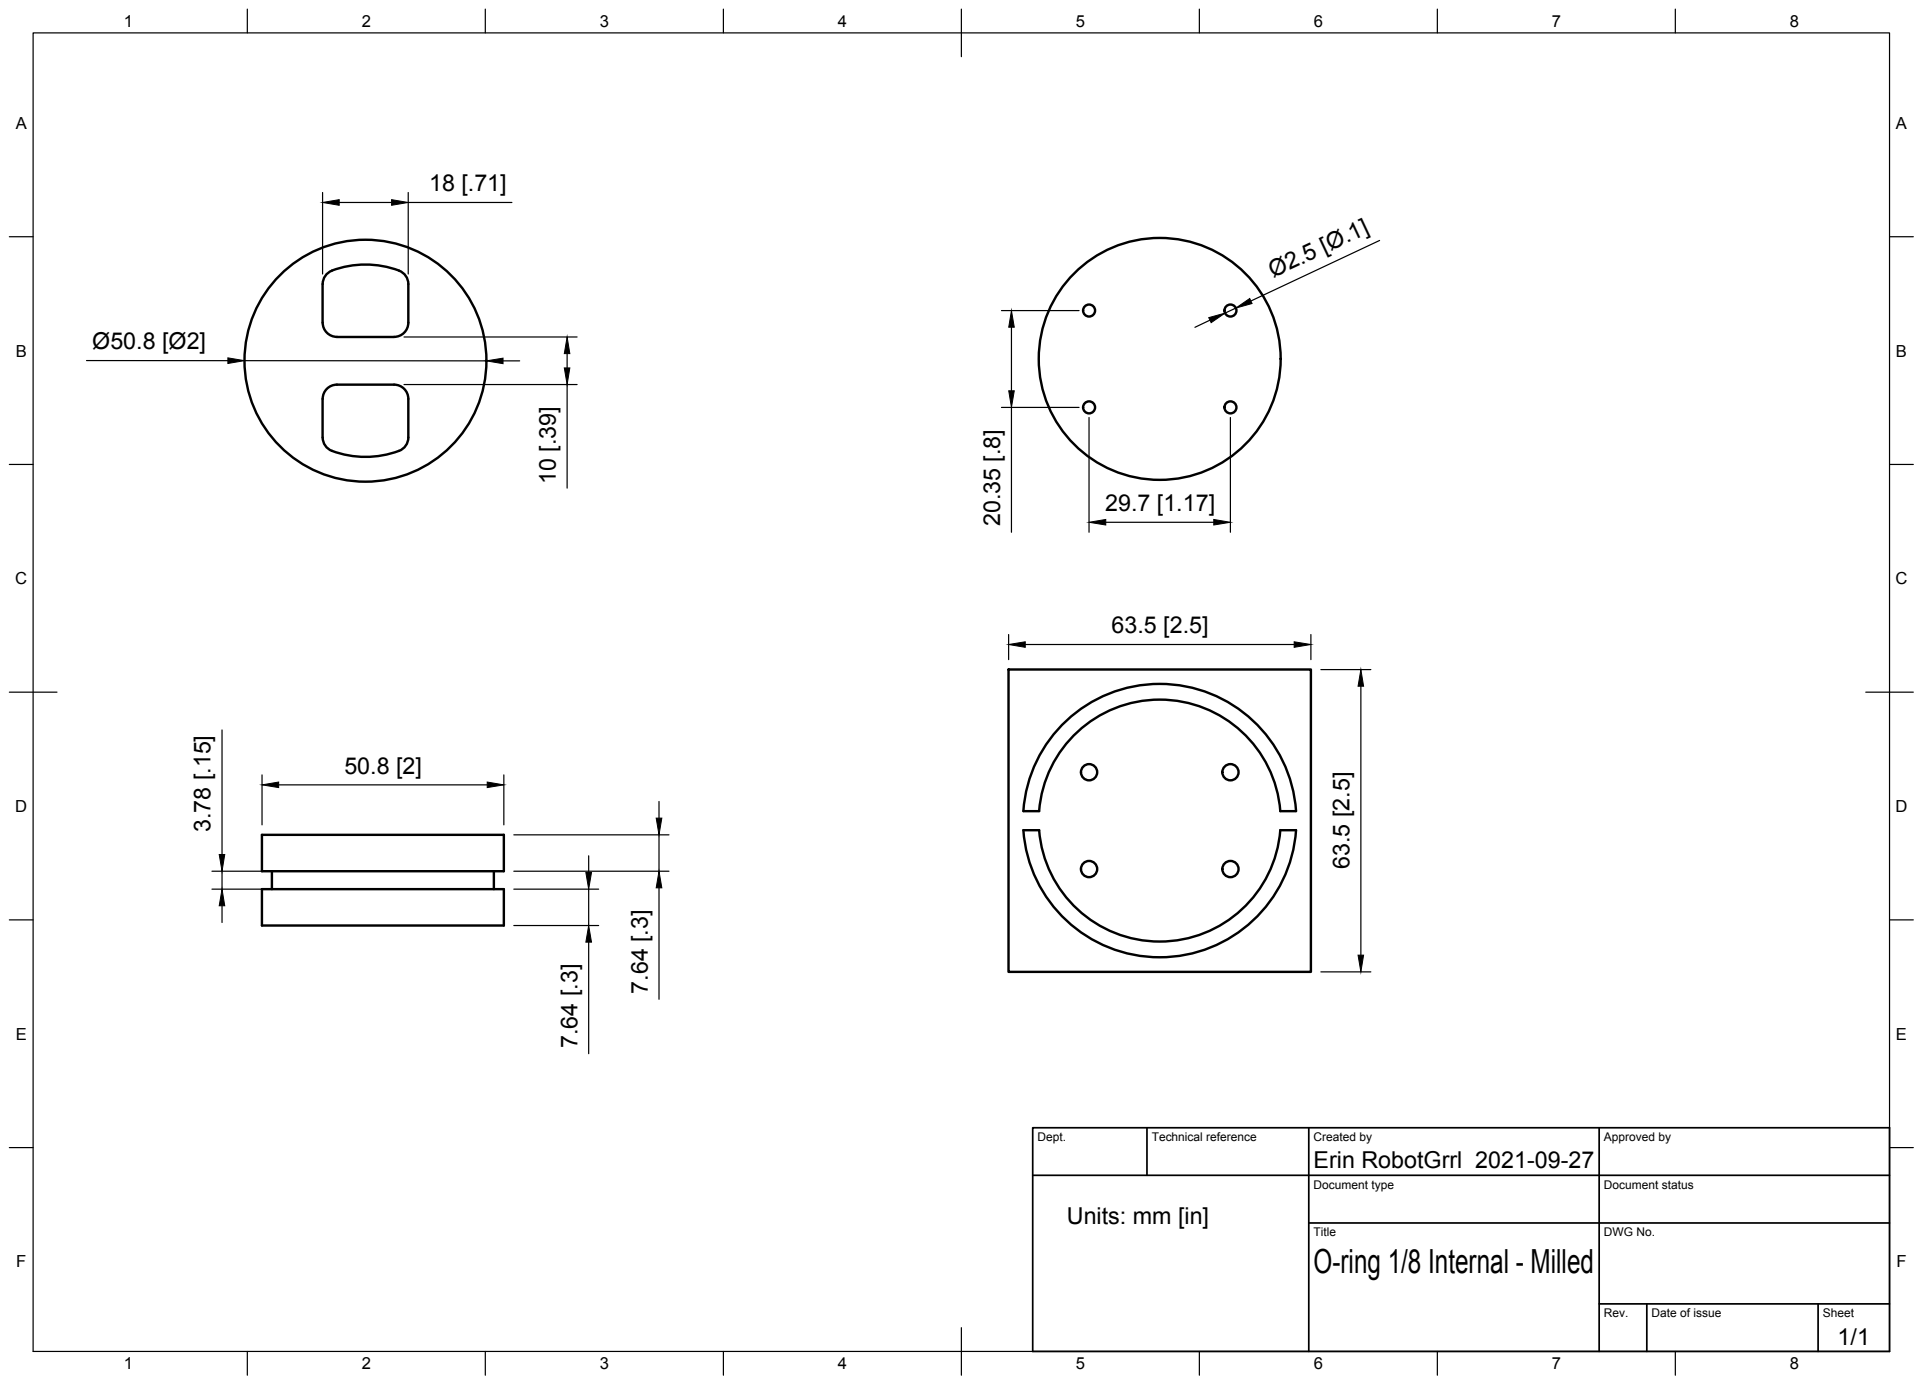
[picture p77: page 1]
Title; DWG No.; Rev.; Date of issue; Sheet

Dept. | Technical reference | Created by Erin RobotGrrl 2021-09-27 | Approved by

Document type | Document status

Units: mm [in]

O-ring 1/8 Internal - Milled
