RobotGrrl/EJA_v2/lower_stage/Rope guide Drawing.pdf

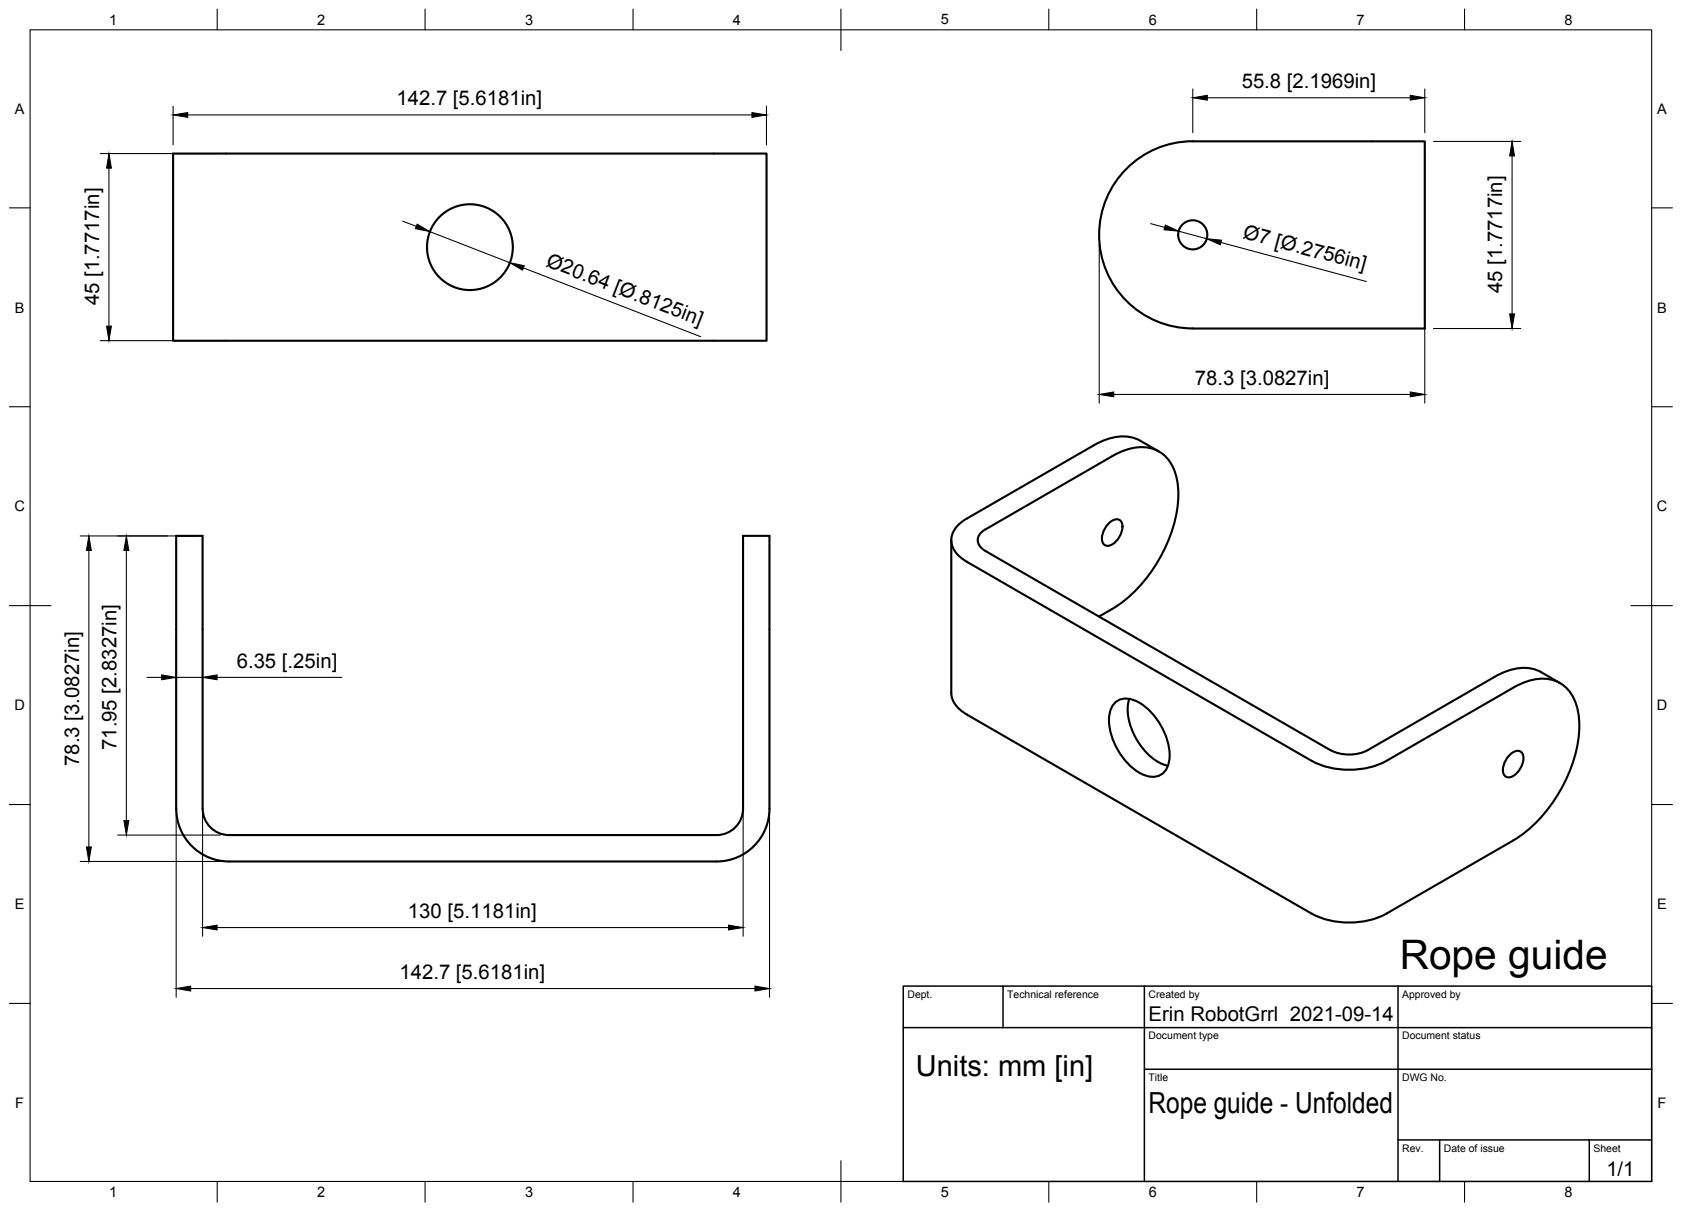
[picture p78: page 1]
Title; DWG No.; Rev.; Date of issue; Sheet; Rope guide

Dept. | Technical reference | Created by Erin RobotGrrl 2021-09-14 | Approved by

Document type | Document status

Units: mm [in]

Rope guide - Unfolded
