RobotGrrl/EJA_v2/external_wiper/External wiper Drawing.pdf

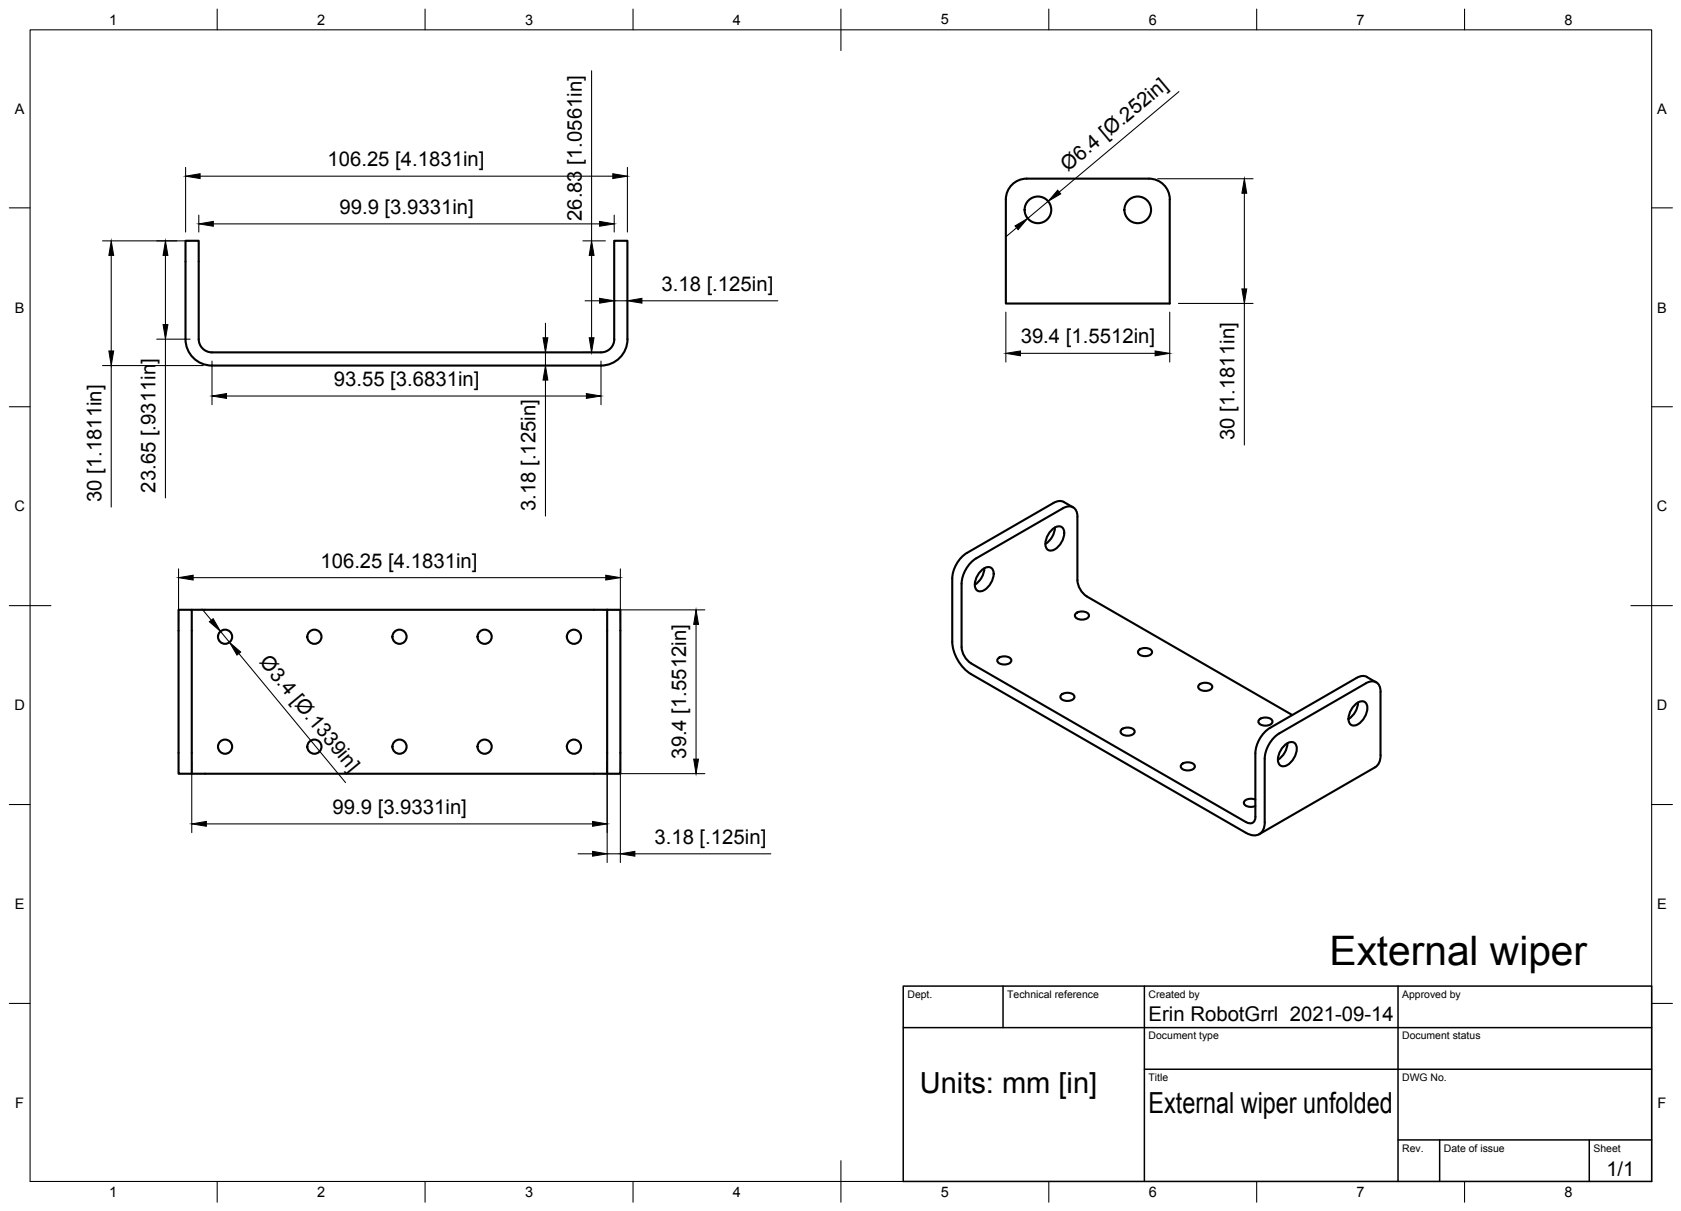
[picture p79: page 1]
Title; DWG No.; Rev.; Date of issue; Sheet; External wiper

Dept. | Technical reference | Created by Erin RobotGrrl 2021-09-14 | Approved by

Document type | Document status

Units: mm [in]

External wiper unfolded
