RobotGrrl/EJA_v2/internal_wiper/Wiper A Drawing.pdf

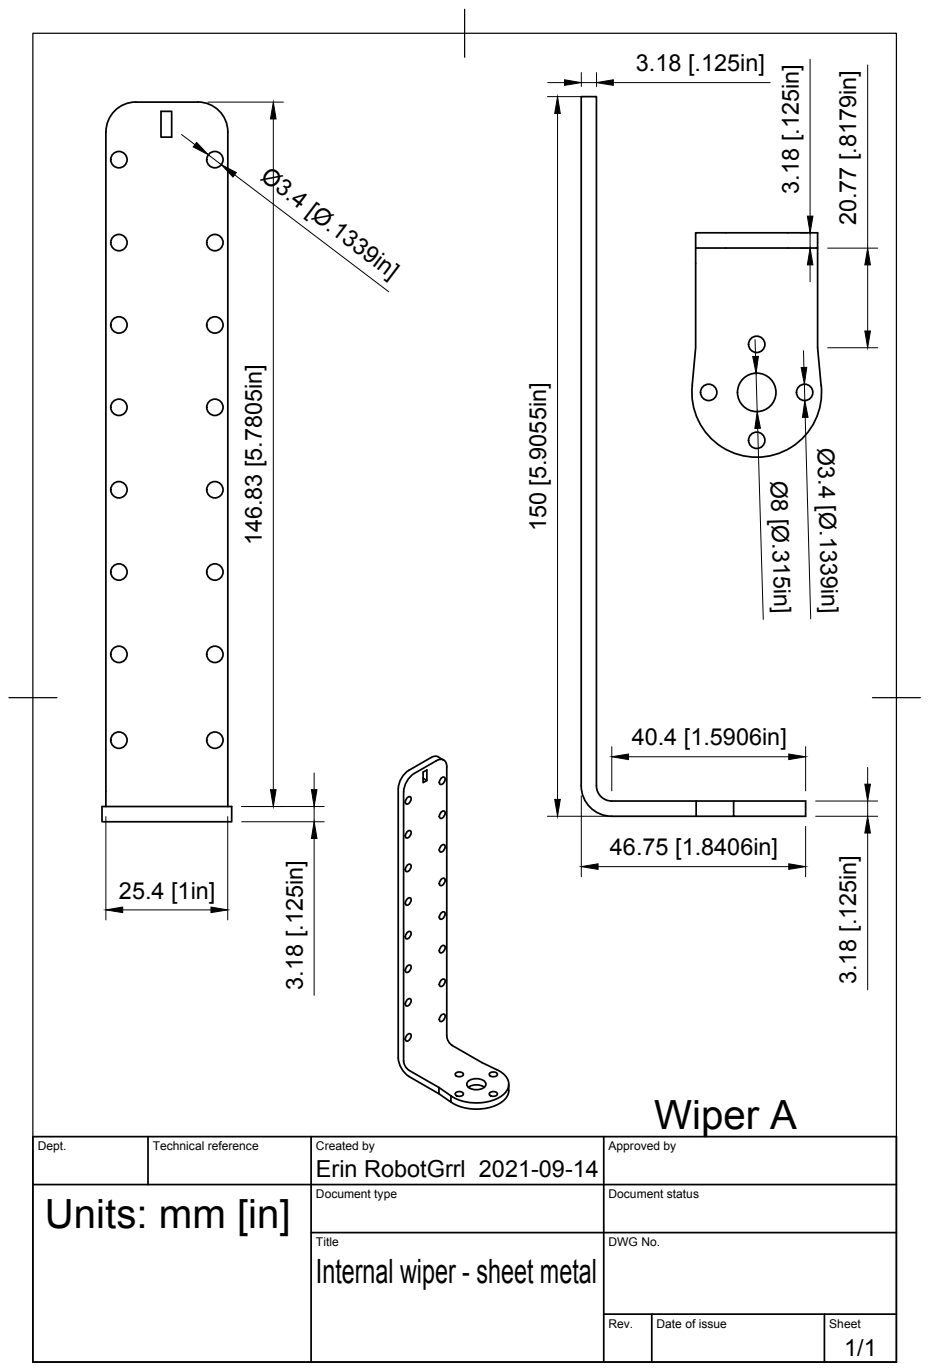
[picture p80: page 1]
Wiper A3.18 [.125in]

Dept. | Technical reference | Created by Erin RobotGrrl 2021-09-14 | Approved by

Units: mm [in] | | Document type | Document status

Title Internal wiper - sheet metal | DWG No.

Rev. | Date of issue | Sheet 1/1
