RobotGrrl/EJA_v2/(commit log)

2021-11-04 Final version for the final presentation
    [Buoy Combined - Magnet Wipers v15.step, Buoy External Wiper v87.f3z, Buoy External Wiper v87.step, Buoy External v28.f3z, Buoy External v28.step, Eja Assembly CFD (v49) 4 v7.step, Internal Wiper v61.step, Lower stage v71.step]
2021-11-04 Adding documentation
    [EJA v2 BOM [FINAL].xlsx, EJA v2 Production [FINAL].xlsx]
